Reflow-Soldering/AltiumDesigner/수정된 사양서/(번역본)Mixed Signal Board 요구사항.docx

Mixed Signal PCB Design

요구사항

개발 작업 설명

중앙 컨트롤 보드

제작사항:

  - 회로도
  - 회로도에 따른 PCB 레이아웃(PCB 설계)

해당 보드의 경우, 사용자가 가지고 있는 설계 프로그램에 따라 다를 수 있으나, 실제적으로 도식의 이해가 가능하면 허락함.
단, 해당 작성자는 Altium만 사용하도록 한다. Altium의 적응을 높이기 위함

부품 및 통신 방식

  - MCU:
    - STM32F103디버거가 포함된 STM32F407시리즈
  - 통신 사양:
    - Ethernet (통신 속도 : 2MB/s)
    - USB 2.0
    - CAN Bus (통신 속도 : 1MB/s)
    - UART
  - 기타 부품
    - ADS1220C04PW
      - Programmable Gain Amplifier
      - Resolution : 24bit
      - Sample Rate 100SPS
      - 0~10mV 차동 입력 진행(Common Mode 전압은 2.5V)
    - DRV8701
      - Bi-Directional Motor Driver 2개
      - Duty: 0% to 100%
      - Power Consumption: 12V 3A (36W)
    - I2S를 이용한 DAC 헤드폰, 스피커 앰프
    - 마이크와 연결될 CODEC

개발자에 따른 사양 지정 – 여기서는 교육 내용과 똑같이 진행한다.

  - Ethernet Physical IC
  - Vref IC, Regulator, Clock Generator
  - 그 외 부품(교육 내용을 따라가도록 한다)
  - 전원 스위치
  - 커넥터

위와 같은 사양으로 진행하며, 부품을 개인차에 따라 쓰지 않는 이유는 이미 라이브러리 제공이 되어있으므로 이를 이용하기 위한 목적이다.

HIGH-SPEED BOARD DESIGN TASK - AUGUST 2017 2
