Reflow-Soldering/AltiumDesigner/다운로드 리소스/Component Naming Convention.xlsx

Sheet: Schematic
SL.No | Part Type | REF-DES | Comment | SYMBOL REFERENCE | Examples
1 | IC'S | U | Part name | IC_Part No.
2 | CRYSTALS | Y | Value | XTAL_Frequency-p art no.
 | Oscillator | Y | Value | OSC_Frequency-Pa rt No.
 | Resonators | X | Value | XTAL-R_Frequency -Part No.
3 | CAPACITORS
 | Capacitor | C | Value | CAP_value-voltage- tolerance-Package
 | Capacitor Polarised | C | Value | CAP-P_value-voltag e-tolerance-Packag e(Case CODE) | CAP-P_10F-50V-10 %-1411(CASE-B)/R AD | RAD- Radial
 | Capacitor Non-Polarised | C | Value | CAP_value-voltage- tolerance-Package
 | Capacitor networks | CN | Value | CAP-N+No. of pins_value-voltage-t olerance-Package
 | Capacitor arrays | CA | Value | CAP-A+No. of contacts/row_value- voltage-tolerance-P ackage
 | Capacitor Variable | C | Value | CAP_value-voltage- tolerance-Package
 | Capacitor Box | C | Value | CAP-B_value-voltag e-tolerance
 | Capacitor Kit | CK | Value | CAP-K_value-voltag e-tolerance-Packag e
4 | DIODES
 | Diode | D | Part name | DIO_Vr -Current If-Package
 | Diode Array | D | Part name | DIO-A_Type-PartNo -Package | DIO-A_S/T/Z-Part No.-Package
 | Diode Zener | D | Part name | DIO-Z_Voltage Zener (Vz)-Power-Packag e
 | Diode schottky | D | Part name | DIO-S_Voltage forward Vf-Voltage reverse Vr-Current forward If-Package
 | Diode TVS | D | Part name | DIO-T_Voltage breakdown Vbr-Voltage Vc-Current Ip-Package
5 | FUSES
 | Fuse | F | Value | FUSE_Trip/Rating c urrent-voltage-pack age-Type | FUSE_0.20A-30V-1 206-RST (RST- Resetable, NON-RST-- Non Resetable )
 | Fuse thermal | F | Value | FUSE-T_Trip current-voltage-pac kage-Type
 | Fuse Holder | FH |  | FUSE-H_Part No-Package/Mounti ng type | FUSE-H_3557-2-T H
 | Fuse Assembly | FA |  | FUSE-A_Trip Current/Current Rating-Voltage-Pac kage/Mounting Type-Type
6 | FILTERS
 | Filter | FL | Part name | Filter_Type-Attenua tion Value-Voltage rated-Current-Pack age/mounting type | FILTER_LP-44dB@ 100MHz-500V-10A- 2220
7 | FERRITE BEAD
 | Bead Ferrite | B or FB | Value | FB_Impedance-freq uency-current rating-package
 | Bead Arrays | B or FB | Value | FB-A+no. of contacts/row_Imped ance-frequency-curr ent rating-package
8 | JUMPER | JP | Value | JMP+no. of channel_package/Pi tch/Part No
 | Jumper CAP |  |  | JMP+no. of channel_Package/P itch-CAP
9 | INDUCTORS
 | Inductors | L | Value | IND_value-current-t olerance-Package/ Mounting type
 | Inductor-Iron | L | Value | IND_value-current-t olerance-Package/ Mounting type
 | Inductor variable | L | Value | IND-V_value-curren t-tolerance-Package /Mounting type
 | Choke | L | Value | IND-C_impedance @frequency-Curren t-Mouting type | IND-C_220Ohm@1 0kHz-6A-TH
 | Inductor Kit | LK | Part name | IND-K_Value Range-Part No-Package/Mounti ng type | IND-K_0.10~33uH- SRP-A-LAB2-S MT
10 | LED'S & DISPLAYS
 | Single LED | DS | Part name | LED_color- Voltage Vf- Current If-Package | LED_YLW/RED/BL U/GRN-2.2V-20mA- package
 | DISPLAYS | DS | Part name | DSP_Configuration- color-Part No-Package | DSP_128x64LCD-Y LW-JHD12864E-TH
 | LED RGB | DS | Part name | LED_RGB-Part No.
 | LED Others | DS | Part name | LED-Type_Part No-Package/Mounti ng type | LED-IR_VSMY3850 -GS08-SMT
11 | MOV | MOV | Part name | MOV_AC voltage-clamp voltage-Package/M ounting type
12 | POTENTIOMETER S | POT | Value | POT_value-Part No_Package/Mounti ng type
13 | RELAYS
 | Relays | RL | Part name | RLY+no. Of channels_Coil voltage-coil current | RLY2_4.5V-2A
14 | RESISTORS
 | Resistor | R | Value | RES_value-wattage -tolerance-package | RES_0.005R-1W-1 %-1632
 | Resistor networks | RN | Value | RES-N+no. of contacts_value-watt age-tolerance-pack age
 | Resistor arrays | RA | Value | RES-A+no. of channels_value-wat tage-tolerance-pack age | RES-A4_0.005R-1 W-1%-1632
 | Resistor Variable | VR | Value | RES-V_value-watta ge-tolerance-packa ge
 | Resistor tapped | R | Value | RES-T_value-watta ge-tolerance-packa ge
 | Resistor Kit | RK | Value | RES-K_value-watta ge-tolerance-packa ge | RES-K_10~97.6R-6 2.5mW-1%-0402
15 | REGULATORS | U | Part name | REG_Voltage Vi-Voltage Vo- current-wattage-Pac kage/Mounting type
16 | RECTIFIERS | REC | Part name | REC_Type-PIV- Voltage Vf@Current If-Package/Mountin g type
17 | SWITCHES
 | SWITCHES | SW | Part name | SW+No of Channels_Part No-TH/SMT
18 | SPEAKERS | SPK | Value | SPK_wattage-impe dance
19 | TRANSISTORS
 | NPN | Q | Part name | TRNS-NPN_ Voltage Vce- Current Ice-package
 | PNP | Q | Part name | TRNS-PNP_ Voltage Vce- Current Ice-package
 | IGBT | Q | Part name | TRNS_Voltage Vceo- Current Ic-package
 | MOSFET | Q | Part name | MOSFET-N or P_Voltage Vds- Current Id-package | N : N channel ; P : P channel
 | Array | Q | Part Name | TRNS-A_ PNP/NPN/(PNP-NP N)-Voltage Vce- Current Ice-package | TRNS-A_PNP-45V- .1A-SOT-353
20 | THERMISTORS | RT | Part name | RT_Resistance-Typ e-package
 | THERMISTOR ASSEMBLY |  | Part name | RT-ASMLY_Thermi stor Part No_Housing part No_Crimp Type | RT-ASMLY_NTCLE 100E3222HB0_440 129-2_SKT
21 | TEST POINT | TP |  | TP_Size-SMT/TH | TP_30D60_TH, TP_40x40-SMT
22 | TRANSFORMERS | T | Part name | XMER_No of contacts-Part No.
23 | CONVERTERS | U | Part name | MOD-AC/DC_Part No.
24 | MODULES | U | Part Name | MOD-Type_Part No. | Eg2: MOD-RF_XB8-DM US-002
25 | SENSOR MODULES | U | Part Name | SNSR_Type-Part No-Mounting Type
26 | ANTENNA | ANT | Part name | ANT_Frequency-Pa rt No
27 | GDT | GDT | Part Name | GDT_Impulse Discharge Current_Voltage
28 | Mechanical Part | MP | Part name | MP_Part No_SMT/TH
29 | Board
 | PCB |  |  | PCB_XXX-XXX-RX XX
 | Gerber |  |  | GBR_XXX-XXX-RX XX
 | Evaluation board |  |  | EVAL_Part No
 | Library |  |  | LIB_XXX-XXX-RXX X
30 | VARISTORS | RV | Part Name | VAR_Varistor Voltage (Typ)-Current -Mounting Type/Package
31 | Light Pipes | LP | Part Name | LP_No of Diffusers-Part No.-Related Package
32 | FAN/LAMP | FA | Part Name | FA_FF-Dimensions( LxB)-Cutout Size-Mounting(Pan el Cutout/Click fitting)-Color
33 | TEST PROBE |  | Part Name | TEST-PROBE_PA RT NO.
 | lithium polymer |  | Part Name | BAT-LP_Capacity-P art No-Type-Shape |  | Non Rechargeble: NON:RCH Rechargeble: RCH
35 | BATTERY HOLDER | BH | Part Name | BAT-H_Part No-Typ e of Battery-Mountin g Type
36 | TBU | TBU | Part name | TBU_Working Volt-Clamping Volt-ESD (Volt)-Mo unting Type | TBU_300V-650V-2 KV-SMT

Sheet: Connectors
SLNO | PART TYPE | REF-DES | VALUE FIELD | DESCRIPTION | Examples
1 | GENERAL TYPE
 | Berg strip | P/J | Part name | CON-BS-PLG/SKT_Pin s in the row X no.of rows-Pitch-mating type-mounting type | CON-BS-SKT_5X2-100 -ST-TH
 | PLUG - Plug | P | Part name | CON-PLG_Pins in the row X no.of rows--Pitch-mating type-mounting type | CON-PLG_80X2-100-R A/ST-TH/SMT
 | SOCKET- Socket | J | Part name | CON-SKT_Pins in the row X no.of rows-Pitch-mating type-mounting type | CON-SKT_80X2-100-R A/ST-TH/SMT
 | TRBLK-Terminal block | J | Part name | CON-TB_Pins in the row X no.of rows-Pitch-mating type-mounting type
 | EDGE-Edge connectors | J | Part name | CON-ED_No.of Pins-mounting type
 | FLEX-Flex connectors | J/P | Part name | CON-FLX_Pins in the row X no.of rows-Pitch-mating type-mounting type
 | BNC | BNC | Part name | CON-BNC_No.of Pins-Pitch-mounting type
 | IDC Connector | J | Part name | CON-IDC+No of Pins_Pitch-mounting type
 | Housing | J/P | Part name | CON-HSG+Pins in the row X no.of rows_Pitch-mating type | CON-HSG2X2_100-ST/ RA
 | BOX- box type | J/P | Part name | CON-BOX+No of Pins_Pitch-mounting type
 | Circular Connector | CN | Part name | CN_PM_C-Shell Type-No. of Pins-Plug/Socket-A/B/X /S"Space"Coded | CN_PM_C-M12-12POS .-SOCKET-A CODED
2 | EURO CONNECTORS
 | P - Plug (Male) | P |  | CON-EP_Pins in the row X no.of rows-mating type-mounting type
 | R - Receptacle(Female) | P | Part name | CON-ER_Pins in the row X no.of rows-mating type-mounting type
3 | Special DIN CONNECTORS
 | CIRDIN - Circular din connector | DN | Part name | CON-CIRDIN_No.of Pins-mounting type
 | MDIN - Miniature din connector | DN | Part name | CON-MDIN_No.of Pins-mounting type
4 | DSUB connectors
 | STD DSUB Connector | P | Part name | CON-DSUB_No.of Pins-mating type-mounting type
 | STD DSUB Connector Housing |  |  | CON-DSUB-H_No.of Pins-mating type-mounting type
 | BACKSHELL |  |  | CON-SHELL_No.of Pins-Length(mm)-matin g type
5 | MEMORY MODULES
 | SIMM | J | Part name | MM-SI_No.of Pins-mounting type
 | DIMM | J | Part name | MM-DI_No.of Pins-mounting type
 | SD Card | J | Part name | SD-Family_Type-Stora ge | SD-HC_Mico-8GB
6 | Special Connectors (Irregular pitch/circular) | J | Part name | CON+no. of pins_Connector type-Part No. | CON4_USB-A-87520-0 010BLF
 | RJ PCB Mount | J | Part name | CON-RJXX_Part No-M ating type-mounting type | CON-RJ45_SS71800-0 27F-ST-TH
 | Hermaphroditic Connector | JP | Part name | CON-HC_Pins in the row X no.of rows_Pitch-Part Number_mounting type | CON-HC_50X2_25_LS S-150-02-F-DV-A_SMT
7 | Coaxial Connectors | J/P
 | PLUG - Plug | P | Part name | CON-Connector Style-S KT_Part No-Mounting type | CON-SMA-SKT_5-1814 832-1-TH
 | SOCKET- Socket | J | Part name | CON-Connector Style-P LG_Part No-Mounting type
8 | CRIMP
9 | HDMI, DVI Connectors | J/P
 | HDMI Connectors | J/P | Part name | CON_Connector type_Part No-Mating type-Mounting type | CON_HDMI-A/B/C/D/E _685119136923-RA-TH
 | DVI Connectors | J/P | Part name | CON_Connector type_Part No-Mating type-Mounting type | CON_DVI-A/D-S/D-D/I- S/I-D_0743201007-RA- TH

Sheet: Footprint
FOOTPRINT NOMENCLATURE
1 | IC | PACKAGENAME+NO OF PINS_PITCH_OUTER TO OUTER DIAMENSION_PADWIDTHX PADLENGTH_MOUNTING | SOIC8_50_284_25X90_SMT
2 | Modules | MOD_ManufacturePartNo_M ountingType
3 | Capacitor | CAP_Package
4 | Tantalum | TCAP_Package_Case Code | TCAP_1210_CASE-T
5 | Aluminium | ACAP_Pitch_Body Dimension_Mounting type | ACAP_P3.5_5X3_H8_SMT | in mm
6 | Electrolytic | ECAP_Pitch_Body Dimension_Mounting type | ECAP_P3.5_D5_H8_TH | in mm
7 | Other Cap | CAP_Pitch_Dimensions_Mo uting type
8 | Resistor | RES_Package
9 | Resistor Array | RES+No of Channels_Package/Part No_Mounting type.
10 | Potentiometer | POT_Part No_Mounting type.
11 | Crystal | XTAL_Part No | For Vertical component add -VM at the end of convention
12 | Oscillator | OSC_Part No.
13 | Diode | DIO_Package_Mounting type. | DIO_DO-35_VM
14 | Std Connector | CON+No of pins_Pitch_DrillDPAD_moun ting type_mating type | CON3_78-74_32D66_TH_R A
15 | Other conn | CON+No of pins_Pitch_Part No_Mating Type_mounting type | CON80_31.49_FX18-80P-0. 8SV10_ST_TH
16 | RJXX Conn | CON+No of pins_RJXX_Part No_Mating Type_mounting type
17 | Dsub Conn | CON_DB+Pin No. _PLG/SKT_Mounting Type | CON_DB25_PLG_TH
18 | Transformer | XMER _Part Number_TH/SMT | XMER_HX1188FNLT_SMT
19 | Switch | SW_Part No_TH/SMT
20 | Inductor | IND_Package/Part No_TH/SMT
21 | LED | LED_Package/Part No_TH/SMT
22 | FUSE | FUSE_Package/Part No_TH/SMT | FUSE_37414000410_TH-RA D
23 | GDT | GDT_Part No_TH/SMT
24 | RELAY | RLY_Part No_TH/SMT
25 | MOV | MOV_Part No_TH/SMT

Sheet: Footprint Creation
Footprint Creation and Nomenclature
 |  | Outer to Outer = distance between pad outer edges (WL)
 |  | Inner to Inner = distance between pad inner edges (Wb)
 |  | Pitch = distance between two adjacent pads/pins center (P)
 |  | Pitch 1 = distance between two pads/pins center of other row
 |  | Pitch 1 = Outer to Outer- 1 pad length
 |  | Inner to Inner = Outer to Outer- 2 pad length
 |  | Preferred pad length for soldering 0.5mm(20mils
Footprint creation from component diag (std)
QFN & DFN | Outer to Outer = Outer to outer(data)+50 | Pad length = pad length (data)+25
SOP,LCC & OTHER QUAD PACKAGES | Outer to Outer = Outer to outer(data)+40 | Pad length = pad length (data)+40
BGA | Pad dia = dia(data)x.8+1
Discrete | Give minimum 20 mils for soldering
COMPONENT OUTLINE (comm on) | Body Length = L(data)+20 mils
Fiducials for component= 20D40 |  | 20 mils pad,40mils soldermak & 40mils layer keep out
Fiducials for board(global)= 40D80 |  | 40 mils pad,80mils soldermak & 80mils layer keep out
