Reflow-Soldering/AltiumDesigner/수정된 사양서/프로젝트 사양서.xlsx

Sheet: DAY-1(한글)
개발 사양서 조건표
요구 사항 | 확인사항 | 실제 사양 | 가능여부 | 비고
MCU (STM32F407Vx,Zx,Ix 3종 중 하나) | GPIO 수 | 가변(Package 및 MCU 따라 변경) | 무관
 | I2C 수 | 가변(Package 및 MCU 따라 변경) | 최소 1개 가능
 | UART 수 | 가변(Package 및 MCU 따라 변경) | 최소 1개 가능
 | Clock | 최대 168MHz | -
 | Flash 용량 | 512KB/1024KB | 코드 용량에 따라 다름
 | RAM | System : 192KB Backup : 4KB | 처리에 따라 다름
 | VDD | 최대 4V(VDD) | 기본 3.3V 진행
Debug Environment (STM32F103) | 동일 벤더 디버거 | ST-LINK 계열 | 부품 추가
 | 동일 사양 버스 필요 | - | 32bit Bus Line
비트 주소 | Bit 수 | 32Bit | 2^32
 | Clock 주파수 | 미정 | 168MHz 이하여야함
 | Prog. Interface | SWD방식
Ethernet PHY | Datalink Layer | LAN, WAN, Wireless | 광통신,Twisted Pair | MAC Address 사용
 | Physical Layer | H/W(Raw Data)
MII/RMII | Media | 사양서는 2MB/s bit로 환산 시 16Mb/s MII에 만족함 | MII로 선정 가능 | https://blog.naver.com/mhyoo1228/221856706981
MII(신호선 16개) | 100Mbits/s
RMII(신호선 7개) | 1Gbits/s
GMII(신호선 24개) | 10Gbits/s
MII Clock | 25MHz
RMII Clock | 50MHz
Phy | 드라이버 사용가능
UART to USB Converter | FT232, CH340C |  | 부품 추가
CAN Bus | - | MCU 가능 | 가능
UART | - | MCU 가능 | 가능
Analog To Digital Converter | 비트 수 | 24 | MCU 12 bit 부품 추가
 | Reference Regulator | 5V
 | Program Gain Amp | 128
 | Sampling Rate | 100SPS
 | Data +, Data - | 0 ~ 10mV
4-Wire Load Cell | CM Voltage | 5V | 부품 추가
Sensor(5KG Load Cell) | 5Kg Load Cell 감도 | 1mg/V | 총 5mg 측정가능
 | 인가전압 | 5V
 | 스텝 수 | 1000000
 | 필요 ADC 비트 | 20bit이상
ADC | 샘플링 비 | 100SPS | MCU 12bit 불가 differential 부품 추가
 | 샘플링 필터 | -
 | 채널수 | 1개
 | 통신 | UART, I2C, SPI
 | 추가기능 | ESD, Noise rejection
 | Noise Free Bits | -
 | Effective Bits | -
 | Voltage Level | -
Motor Driver | Bi-Directional | Bi-Directional Modor(H type) | 부품 추가
 | 0-100% | PWM
 | Motor Input Voltage | 12V
 | Logic Level H Voltage | 3.3V
 | Motor Type | Brushed DC
 | TR종류 | Power MOSFET
 | 규격 | GPIO 1, PWM 1
 | 보호 기능 | OVC
 | 전류측정 | 1 ADC
 | 가격 | -
MOSFET | Rds(on) | 작을수록 좋음 | 부품 추가
 | Id | 3.5A 초과
 | V(gs) | 9V 초과
 | Ids(Off) | 최소
 | Power Disspiation(Pd) | I^2*Rds(on)
 | Rth(JA) | 최소 온도(발열로 인한 손상 최소화)
 | Total gate charge | 최소 Q로(Gate Open Delay 최소화)
 | Switching Loads(inc) with total gate Charge
 | no elements
DAC | Sampling Rate | 64x Fs
 | 요구 채널 수 | 1채널
 | 통신방식 | I2S
 | 분해능 | 32bit
 | 아날로그 출력 수 | 1개 -> 헤드폰, 스피커
 | 전압 | 3.3Volt
 | 마이크 | 1개 -> 헤드폰
 | monotocity | -
 | 오디오 범위(dB) | High minus low Audio
선정 부품 | 모델명 | 제조사 | 패키지 | Description
MCU | STM32F407VGT6 | STMicroelectronics | LQFP100 | Cortex-M4, FLASH 1MB, 12bit ADC, SRAM 192KB
Progammer/Debugger | STM32F103CBT6 | STMicroelectronics | LQFP48 | Cortex-M3, FLASH 128KB, 12bit ADC, SRAM 20KB
Ethernet PHY | DP83826IRHBR | Texas Instruments | QFN-32 | PHY MII,RMII
UART to USB 2.0 | CH340C | WCH(China) | SOP-16 | USB to Serial
ADC (Load Cell용) | ADS122C04IPW | Texas Instruments | TSSOP | 24bit ADC, PGA, Reference, 4-ch(Single), 2-ch(Diff)
Motor Driver | DRV8701ERGET | Texas Instruments | VQFN-24 | PH/EN Control, H-bridge Motor control
MOSFET | DMHT6016LFJ | Diodes | V-DFN5045-12 | 60V N-CHANNEL ENHANCEMENT MODE MOSFET H-BRIDGE
DAC | CS43L22 | CIRRUS LOGIC | QFN-40L | Low Power, Stereo DAC(headphone, Speaker amps)
마이크 | IMP34DT05 | STMicroelectronics | HCLGA 4LD | MEMS audio sensor omnidirectional digital microphone
RLC | - | Any | Any | R,L,C 종류별 사용
특수 부품 | Ferrite Bead, OSC 등 | Any | Any | 종류별로 사용

Sheet: DAY-2(한글)
STM32F103 Debugger 참조 사항
참조 | Page | Description | 내용 | 비고
STM32F103 Datasheet | Page 11 | 블록 다이어그램 | 전체적인 내부 구조 설명 | JTAG/SWD 블록 확인
 | Page 15 | Boot Modes - 3 State | Boot 모드 설명 | AN2606 - Chapter 18 참조(부트모드) - 19는 105 Reference Manual도 참고할것
 | Page 26 | LQFP 48 PinOut | Pin Out 설명 | 각 핀의 명칭 포함되어있음
 | Page 28-33 | 103 Pin Definition | Pin Description | 각 핀 Deafault/Altenative 포함
 | Page 35 | Load Cap, VDD | Load Cap(for OSC), VDD 구조 | 기본 3.3V 테스트/ 테스트 방법
 | Page 36 | Power 구조 | (A)VDD,(A)VSS,Vref 설명 | Voltage만 나오지만 블록 다이어그램 있음
 | Page 37 | Absolute maximum ratings | 절대기준(V,I 등) | 절대 기준, Operating Condition으로 볼 것
 | Page 51-56 | Clock Config | 내부 클럭/외부 클럭 설명 | External 8MHz 사용 할 예정
 | Page 59 | ESD(정전기) | 저항 가능한 정전기 | 인체/충전기모듈 기준 설명
 | Page 66 | NRST Pin | RESET(Active Low) | 테스트 리셋 불필요 시 스위치 불필요
 | Page 69 | I2C 사용 주의 사항 | Should place Pull-up | 풀업 저항 + 직렬 저항(노이즈 떄문인듯)
 | Page 77 | Design Guidelines | General PCB Design | 가이드라인 제시
Bypass Caps
Series Termination Resistance | 1Mhz | 3.3v<x
 | ns
10R | 0.2V

Sheet: Day-3(한글)
ESD Diode/Ferrite Bead 선정
내용 | 속성 | 요구사항 |  | 비고 | 선택 부품
ESD DIODES/TVS DIODES | 누설전류 | 적을수록 좋음 |  | 전력 소모량에 영향 | ESD3V3D9 |  |  | Clamping 전압은 MCU의 Absoulte maximum voltage 보다 낮은게 좋긴 하다
 | 동작전압 | 3.3V |  | MCU 공급 전압에 따름
 | Break down 전압 | 3.3V보다 클 때 |  | 3.3V보다 클 때와 반응속도가 빨라야함
 | 클램핑 전압 | 동작전압에 가까울 수록 좋음 |  | MCU공급 전압이 3.3V이므로
 | 기생 커패시턴스 | 최소 |  | 고주파에서 GND로 가며, 신호 감쇠 영향
 | 방향성 | 단방향 |  | 0~3.3V이므로
Magnetics with RJ45 | RJ45 Magnetic | 절연상태(내부 Trans 사용) |  |  | G8X-188S7-BP
 | Working Voltage | -
 | Isolation Voltage | -
 | Speed | 100Mbps 가능 |  | 요구사항 2MByte/s
Ferrite Bead | Rdc | 낮을수록 좋음 |  | 높으면 전압 강하를 일으킴 | MPZ1608B471ATA00 |  |  | 비드는 노이즈를 확인하고 특정 주파수 라인 제거를 목적 (Knee Freq 확인 필)
 | IMP | 높을수록 좋음 |  | 원하는 주파수 내에서만 높아야함
 | FREQ | 요구 주파수 내 |  | 원하는 주파수에서의 임피던스 확인 필
 | Current | Ethernet PHY TX+, TX-, RX+, RX- 라인당 전류 |  | 동작 전류보다 낮으면 발열/소손 예상
SWD/JTAG | JTAG과 SWD는 선택사항 |  |  | SWD -> 프로그램, 디버깅, ARM 아키텍쳐, printf 가능 JTAG -> Test, 독립적, 별도의 아키텍쳐 없음
Symbol Desing | IPC-STD-2612
Footprint | IPC-STD-7351
 |  |  |  |  |  | 용량성 리액턴스(Xc) | 1/(2*pi*C) | FC(High), C(High) Imp (Low)
 |  |  |  |  |  |  | TX+, TX-, RX+, RX-
 |  |  |  |  |  | SWD | SWDIO, SWCLK, GND
 |  |  |  |  |  | JTAG(4/5) | JTNRST, JTCK, JTMS, JTDI, JTDO, GND
 |  | SWD | JTAG
 |  | Programming / debugging | testing (Max processing)
 |  | Arm arch | independent
 |  | print during deb | not

Sheet: DAY-4(한글)
모터 드라이버 IC 설계 사항
명칭 |  | 단위 | 결과 | 설명
ICHOP |  | 3A | 3A | 지정된 전류값 초과시 정지한다 Vref 필수 - AVDD에서 분압
VREF |  | Unknown | 3.05V | Chopping 위한 Vref 레벨 8.2.1.2.3 참고하여 계산
VOFF |  | 0.05V | 50mV | VOFF시 Typical 전압
AVDD |  | 4.8V | 4.8V | 내부 레귤레이터 6.3V 1uF 세라믹 권장
Gain(Av) |  | 20 | 20V/V | ICHOP위한 내부 증폭값(Rsense)
Vout(Vref 값) |  | r2*vin/(r1+r2)
r1/r2 |  | 1.8/3.3 | 0.5
r1 |  | 1.5k
r2 |  | 3k
Page no |  | 17
application Page |  | 28
BULK CAPS 선정 | MEANWELL RS-100-12 기준
최소 커패시터 용량 | D*(1-D)*IO/ DELV*Fsw
최대 스위치(Delta) | Vo*100/VIN*eff | 1-((Vin-효율)/Vout)
I0/요구 전류 | 7.6A
VIN=VOUT | 12V
스위칭 주파수(fsw)/민웰 | 60000
효율(eff)/민웰 | 81
출력 리플(delv)/민웰 | 0.12(peak to peak)
최종 리플(Delta) | 1.234568
Cmin | 250uF
3A | ~100uF
ESR | min
Ripple Current | Max
ADC
Page No |  | 52 | Filter Calc |  | 전류(고정) | Voff(고정) | Av(고정) | Rsense | SO(Volt)
FC |  | 1/(2*PI*(R1+R2)*CDIF) | r1=r2=1k |  | 3 | 0.05 | 20 | 0.05 | 3.05
1000
CDIF |  | 100nF
CM1=CM2 |  | 10nF

Sheet: DAY-5(한글)
Charge Pump: | i/p 12v | 24v | Caps | Polar | Non polar
 | 12 |  |  |  | Ceramic
Arangement of Capacitor, Diode, CLK, Gates |  |  |  |  | Class a, Classb
V1 + V1 | 2X 5V | Load voltage |  |  | Class a (Stable, Low Leackage, Low ESR)
Adv | Less compo | Min complex |  |  | MLCC(multilayer ceramic capacitor)
STM32F407
Page-19 | block | SWD/JTAG
Page-24 | Boot pins
Page-25 | PRD ON and Vdd conditions
Page-77 | VDDs, VREF, AVDD, GNDs |  | Pending
Page-82 | Low esr req. for Vcap1 &2 |  | PHY RESET | GPIO
Page-102 | Crystal req |  | Motor driver | 1 PWM, 3 GPIO, 1ADC _IN | X2
Page-112 | ESD Ratings |  | CH340C | 1GPIO
Page-119 | Reset conditions |  | ADC | 2 GPIO
 |  |  | DAC | 1GPIO
 |  |  | MIC | 1 PWM 1 GPIO
Place zener on 1.8
Change net labes motor-2

Sheet: DAY-6
Rules | Some Advantages of MultiLayer Board
First thing is these rules are not enough, because there can be 100s of Rules for a complex PCB. | increases the board's ability to distribute energy
1. ground plane boards are better because they allow signal routing in a microstrip or stripline configuration. It also significantly reduces the ground impedance and, therefore, the ground noise; | reduces cross-interference, eliminates electromagnetic interference
2-high speed signals should be "routed" on intermediate layers located between the various levels. In this way, ground planes can act as a shield and contain the radiation coming from the tracks at high speed | supports high-speed signals
3- a signal layer must always be adjacent to a plane | While a stackup level allows you to get multiple electronic circuits on a single board through the various layers of PCB board
4- Multiple ground planes are very advantageous, since they lower the board's ground impedance and reduce radiation in a common way; | a stack of PCB layers can help minimize the circuit vulnerability to external noise, as well as minimize radiation and decrease impedance and crosstalk problems on high-speed systems
5. the power to Power or GND to GND planes must be rigorously coupled together; | good PCB stacking can also contribute to efficient and low-cost final production;
6- Configurations should be symmetric. For example, on an eight-layer PCB, if level 2 is a plane, level 7 should also be a plane | a correct stack of PCB layers can improve the electromagnetic compatibility of the project.
7. Put the signal levels next to the levels of the plane (ground or power) the return current can flow on an adjacent plane reducing the inductance of the return path to a minimum; | The higher the number of layers, the more the designer is free to unravel his circuit, with less chance of stumbling into "impossible" solution
8. to further improve noise and EMI performance, insulation between a signal layer and its adjacent plane can be made even thinner;
9. an important consideration to be done is the thickness of each signal layer. There are standard thicknesses together with the properties of different types of printed circuit material. When selecting the materials, it is advisable to consider their electrical, mechanical and thermal properties;
Following Factors we have to thing Before and during the design
No of Layer
Number of Planes and Type of Planes
Sequence of Layers
Spacing b/w the Layers

Sheet: Grounding
Grounding
1- Leave nothing unconnected (Fill gnd)
2- Never split the gnd under the signal (Multilayer )
Always connect gnd on common point
Minimize the series via (High freq)
Try to route GND tracks from the biginning (2 layer , 1 layer)
GND to Chasis GND
Reason of Chasis should be gnd(To electric shock)
Current flow from body
higher potential (Body is lower pot)
Lets suppose something touching chasis
0V at chasis
to maintain 0v on chasis we connect it to GND
Very Big PCB, (Try to place Low value cap and Mega ohm reg on every monting hole)

Sheet: day-10
Reverify the schematic | Power Nets | Loads
Critical (Reset, Analogs, sesnors, etc) -Create design rules for Clearance | 12v | 12v (Q2), 12V(U9) | R19
Differential Tracks | 12v Series element NETC84_2 | 3V3 (u8),
Digital tracks | 3V3 | 1v8(u6), 3v3(u6,u7),
Check for each polygon pour | 12v Series element NETC90_2 | 3v3(u5)
 | 1v8 | 3v3(u4)
Place all the designators and naming | 3v3 Series load Net c11_2 | 12v(q1), 12v(u3) | R43
Add a clearance rule for 5mil, adjust all the violations |  | 3v3(u2)
 |  | 3v3(u1)
Current density, Voltage drop (PDN Analysis)
A/unit area

Sheet: Bonus Session
All I/O Voltage Nets | Loads at different Volatge
12V | 12V (Q1,Q2), Current Sesnse (R19, R43)
Series Ele. Netc84_2 | NETC84_2 (U10)
3V3 | 3V3(U1, U2)
