Reflow-Soldering/AltiumDesigner/다운로드 리소스/ADCs Criterias .xlsx

4 Channel ADCs |  |  |  |  |  |  |  | 2020-07-01
MPN | I2C Com | Resolution | Sample rate | PGA(gain amp) | Digital Filter Samples | I/P Volatge | Sensing Voltage | Price < $2 | Distributor
Not Available on arrow & lcsc price started from $2.1
AD7993BRUZ-1 | y | y | 188k |  |  | 3.3v to 5.5v |  | 2.1 | ARROW
ADS7924IRTER | y | 12 | 100K |  |  | 3.3v to 5.5v |  | 2.72
AD7091R-5BCPZ-RL7 | y | 12 | 22.2k |  |  | 3.3v to 5.5v |  | 2.6
ADS7924IRTET | Y | 12 | 100K |  |  | 3.3v to 5.5v |  | 2.1 | LCSC
TLA2024 (https://www.ti.com/lit/ds/symlink/tla2024.pdf?ts=1596114651694) |  |  |  |  |  | 3.3v to 5.5v |  | 1.3 | Digikey (https://www.mouser.in/ProductDetail/Texas-Instruments/TLA2024IRUGR?qs=chTDxNqvsymxVYMOXLVZ5Q%3D%3D)
ADS1015 (https://www.mouser.in/ProductDetail/Texas-Instruments/ADS1015IDGSR?qs=IK5e5L0zOXhCrFZ0pftZqw%3D%3D) |  |  |  |  |  | 3.3v to 5.5v |  | 2.66 | Mouser (https://www.mouser.in/ProductDetail/Texas-Instruments/ADS1015IDGSR?qs=IK5e5L0zOXhCrFZ0pftZqw%3D%3D)
1 Channel ADCs |  |  |  |  |  |  |  | 2020-07-01
MPN | I2C Com | Resolution | Sample rate |  |  |  | Sensing Voltage0-3.3V. | Price < $2 | Distributor
ADC081C021CIMM/NOPB | Y | 8 | 188.9K |  |  | 3.3v to 5.5v | Y | 1.49 | ARROW
MCP3021A7T-E/OT | Y | 10 | 22.3K |  |  | 3.3v to 5.5v | Y | 0.9 |  | i2c Adress Options
MCP3021A3T-E/OT | Y | 10 | 22.3K |  |  | 3.3v to 5.5v | Y | 0.7
MCP3021A2T-E/OT | Y | 10 | 22.3K |  |  | 3.3v to 5.5v | Y | 0.77
MCP3021A4T-E/OT | Y | 10 | 22.3K |  |  | 3.3v to 5.5v | Y | 0.9
MCP3221A4T-E/OT (https://www.mouser.in/ProductDetail/Microchip-Technology/MCP3221A4T-E-OT?qs=uHi2%2FQoPa5A0hdg9CKvRxA%3D%3D) | Y | 12 | 22.3K |  |  | 3.3v to 5.5v | Y | 1.14 | Mouser
Aanalog MUX
8:1 Mux
MPN | Volatge Range | Price
74HC4051PW,118 | 2-5.5V | 0.3
74HC4051PW-Q100,11 | 2-10V | 0.23
74HC4051PW,112 | 2-10V | 0.2
74VHC4051AFT | 2-5.5V | 0.34
TMUX1208 |  | 0.6
8:2 MUX
MPN | Volatge Range 2-6 | Price
MC74VHC4052DR2G | Y | 0.3
SN74HC4852DR | Y | 0.28
NLVHC4052ADWR2G | Y | 0.26
M74HC4852YRM13TR | Y | 0.27
