Reflow-Soldering/AltiumDesigner/다운로드 리소스/MOSFET PARAMETERS.xlsx

Sheet: Index of Mosfets(n channel)
PARAMETERS | RDS(ON) | VDS(V) | ID @100 Deg C | VGS-TH | Transconductance | VGS-MAX | IDSS | P(DIS)-W (ILOAD^2 X RDS) | RTJA | Temperature Rise at ILOAD | Comments |  | Vendors | Total gate charge | I/P Capacitance | SW Freq | Thermal Pad | Bridge confrigration
MOSFET
HAT2092R | 10V, 5.5A, 16mOHM | 30V | 11A |  |  | 20V | 1UA | 0.484 AT 5.5A |  |  |  |  | ARROW | 22NC | 1400PF |  | NO | 2 ELEMENT
IRFHM8363T | 10V, 10A- 14.9mOHM | 30V | 10A |  |  | 20V | 1UA | 1.5W AT 10A | 47 |  |  |  | ARROW | 15nC | 1165PF |  | NO | 2 ELEMENT
IRLHS6242TRPBF | 4.5, 8.5A- 11.7mOHM | 20V | 8.5A |  |  | 12V | 1UA | 0.8W AT 8.5A | 63 |  |  |  | LCSC | 14NC | 1110PF |  | YES | NO
BSZ0909ND | 4.5V, 9A- 25mOHM | 30V | 20A |  |  | 20V | 1UA | 2W AT 9A | 65 |  | Upto 6 Amps Max |  | ARROW | 2.6NC | 360PF |  | YES | 2 ELEMENT
DMHT6016LFJ | 10V , 10.6A, 22mOHM | 60V | 10.6A |  |  | 20V | 1UA | 2.5W AT 10.6A | 108 |  | Up to 5A |  | ARROW | 17nC | 864PF |  | YES | 4 ELEMENT
DMG4822SSDQ | 10V, 10A, 21mOHM | 30V | 10A |  |  | 25V | 1UA | 2.1W AT 10A | 88.4 |  | Good for upto 6A | F=10Khz | ARROW | 10.5nC | 478.9 PF |  | NO | 2 ELEMENT
IRF7470PbF | 10V, 10A - 13mOHM | 40v | 10A |  |  | 12V | 20ua | 1.3w at 10a | 50 |  | Good for 10A | F=10Khz | ARROW | 44NC | 3430PF |  | NO
SSFB3910L | 10V 6A, 13mOHM | 30V | 10A/ 8A(70C) |  |  | 20V | 1uA | 0.4W AT 6A | 62 |  |  |  | ARROW | 12nC | 900pF |  | NO | NO
NVMFD5C478N | 10V, 7.5A, 18mOHM | 40V | 9.8/6.8 AT 100C |  |  | 20V | 10uA | 1W AT 7.5A | 48 |  |  |  | ARROW | 6.3nC | 325PF |  | YES | 2 ELEMEMNT
NVMFD5C466N | 10V, 15A, 8.1mOHM | 40V | 14A/10A AT 100C |  |  | 20V | 10uA | 1.8W AT 15A | 49 |  |  |  | ARROW | 11nC | 650pF |  | YES | 2 ELEMNT
NTMFD5C466NL | 10V, 10A, 12.6mOHM | 40V | 10A AT 100 |  |  | 20V | 10uA | 1.26W AT 10A | 49 |  |  |  | ARROW | 1.5NC | 997PF |  | YES | 2 ELEMENT
AO4838 | 10V, 11A, 9.6mOHM | 30V | 9A AT 100C |  |  | 20V | 1UA | 1.16W AT 11A | 90 |  |  |  | ARROW | 22NC | 1300PF |  | NO | 2 ELEMENT
FDMD8280 | 10V, 11A, 8.2mOHM | 80V | 11A |  |  | 20V | 1UA | 0.9 AT 11A | 60 |  |  |  | ARROW | 44NC | 3050PF |  | YES | 2 ELEMENT
DRV8701
GATE DRIVE VOLTAGE |  |  |  |  |  | 9.5V

Sheet: Mosfet(p channel)
PARAMETERS/ Mosfet Part Number | RDS(ON) mOHM | VDS(V) | ID @100 Deg C | VGS-TH | Transconductance (siemens) | VGS-MAX | IDSS (uA) | P(DIS)-W (ILOAD^2 X RDS) | RTJA (c/w) | Vendors | Total gate charge (nC) | I/P Capacitance (pF) | SW Freq | Thermal Pad mm^2
NVMFS5A140PLZT1G | 4.2 | 40 | 20 @25 | 1.2 | 125 | 20 | 10 | 1.68 | 39 | Arrow | 136 | 7400 | na | 650
IRF7425TRPBF | 13 | 20 | 10 @100 | 1.2 | 44 | 12 | 25 | 1.3 | 50 | Arrow | 130 | 7980 | NA | NA
SQA405EJ-T1_GE3 | 50 | 40 | 10 @125 | 2 | 18 | 20 | 50 | 5 | 90 | Arrow | 33 | 1815 |  | 645
SISS65DN-T1-GE3 | 110 | 30 | 13.8@ 70 | 1 | 47 | 20 | 5 | 11 | 33 | Arrow | 126 | 4427 | NA | 645
SQJA37EP-T1_GE3 | 14.6 | 30 | 30@125 | 2 | 32 | 20 | 50 | 1.4 | 70 | Arrow | 100 | 4900 |  | 645
SISH625DN-T1-GE3 | 11 | 30 | 13.8@70 | 1 | 47 | 20 | 5 | 1.1 | 33 | Arrow | 126 | 4427 |  | na
CSD25310Q2T | 59 | 20 | 9.6 @100 | 0.85 | 34 | 20 | 1 | 5.43744 | 43 | Arrow | 4.7 | 655 |  | 645
IRF9388TRPBF | 11.9 | 30 | 9.6@70 | 1.8 | 20 | 25 | 150 | 1.1 | 50 | Arrow | 18 | 1680 |  | na
FDS4465 | 10.5 | 20 | 13.5 | 1.5 | 70 | 8 | 1 | 1 | 50 | Arrow |  | 8237 |  | 645 of 2oz
IRF9310TRPBF | 6.8 | 30 | 16@70 | 1.8 | 39 | 20 | 150 | 0.6 | 50 | LCSC | 58 | 5250 |  | NA
