Reflow-Soldering/AltiumDesigner/다운로드 리소스/Section-10+Documents/Mixed Signal Board Project - final/PDNAnalyzer_Output/Mixed Signal Board Project/PDN SIMULATION/Results-0/vias.csv

x | y | layer1 | layer2 | voltage1 | voltage2 | current
60.932 | 569.616 | TOP_LAYER | GND | 0.0114816 | 0.0114816 | 1.74069e-14
60.932 | 569.616 | GND | VCC | 0.0114816 | 0.0114816 | -6.31757e-14
60.932 | 569.616 | VCC | BOTTOM_LAYER | 0.0114816 | 0.0114816 | -5.22208e-14
111.201 | 1968.8 | TOP_LAYER | GND | 0.00863185 | 0.00863185 | 5.22208e-14
111.201 | 1968.8 | GND | VCC | 0.00863185 | 0.00863185 | -4.83899e-14
111.201 | 1968.8 | VCC | BOTTOM_LAYER | 0.00863185 | 0.00863185 | -3.48139e-14
130.568 | 1424.43 | TOP_LAYER | GND | 0.011389 | 0.011389 | 5.22208e-14
130.568 | 1424.43 | GND | VCC | 0.011389 | 0.011389 | -2.15066e-14
130.568 | 1424.43 | VCC | BOTTOM_LAYER | 0.011389 | 0.011389 | -0
147.773 | 1784.43 | TOP_LAYER | GND | 3.29894 | 3.29894 | 1.33685e-11
147.773 | 1784.43 | GND | VCC | 3.29894 | 3.29894 | 1.82376e-11
147.773 | 1784.43 | VCC | BOTTOM_LAYER | 3.29894 | 3.29894 | -8.91235e-12
191.568 | 510.432 | TOP_LAYER | GND | 0.0114875 | 0.0114875 | 5.22208e-14
191.568 | 510.432 | GND | VCC | 0.0114875 | 0.0114875 | 1.88183e-14
191.568 | 510.432 | VCC | BOTTOM_LAYER | 0.0114875 | 0.0114875 | 3.48139e-14
204.506 | 1321.08 | TOP_LAYER | GND | 3.29888 | 3.29888 | 1.24099e-11
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
