Reflow-Soldering/AltiumDesigner/다운로드 리소스/Section-10+Documents/Mixed Signal Board Project - final/PDNAnalyzer_Output/Mixed Signal Board Project/PDN SIMULATION/Results-0/vcomp2id.csv

vrefdes | id
VCOMP0 | 0
VCOMP1 | 1
VCOMP2 | 2
VCOMP3 | 3
VCOMP4 | 4
VCOMP5 | 5
VCOMP6 | 6
VCOMP7 | 7
