Reflow-Soldering/AltiumDesigner/다운로드 리소스/Section-10+Documents/Mixed Signal Board Project - final/PDNAnalyzer_Output/Mixed Signal Board Project/PDN SIMULATION/Results-0/vpins.csv

refdes | pin | voltage | current | rpin
VCOMP0 | VCOMP0-0 | 11.9938 | 6.1601 | 0
VCOMP0 | VCOMP0-1 | 0 | -6.1601 | 0
VCOMP1 | VCOMP1-0 | 11.9332 | -1.02736 | 0.05
VCOMP1 | VCOMP1-1 | 11.9311 | -0.985539 | 0.05
VCOMP1 | VCOMP1-2 | 11.9312 | -0.987098 | 0.05
VCOMP1 | VCOMP1-3 | 0.0160381 | 3 | 0.05
VCOMP2 | VCOMP2-0 | 11.9314 | -1.04066 | 0.05
VCOMP2 | VCOMP2-1 | 11.9283 | -0.978711 | 0.05
VCOMP2 | VCOMP2-2 | 11.9284 | -0.980626 | 0.05
VCOMP2 | VCOMP2-3 | 0.017455 | 3 | 0.05
VCOMP3 | VCOMP3-0 | 3.29885 | -0.01 | 16
VCOMP3 | VCOMP3-1 | 0.0113987 | 0.00249997 | 16
VCOMP3 | VCOMP3-2 | 0.0114003 | 0.00249987 | 16
VCOMP3 | VCOMP3-3 | 0.0113972 | 0.00250006 | 16
VCOMP3 | VCOMP3-4 | 0.0113966 | 0.0025001 | 16
VCOMP4 | VCOMP4-0 | 3.29853 | -0.0299241 | 2.96296
VCOMP4 | VCOMP4-1 | 3.2988 | -0.0300173 | 2.96296
VCOMP4 | VCOMP4-2 | 3.2988 | -0.0300171 | 2.96296
VCOMP4 | VCOMP4-3 | 3.29888 | -0.0300448 | 2.96296
VCOMP4 | VCOMP4-4 | 3.29874 | -0.0299969 | 2.96296
VCOMP4 | VCOMP4-5 | 0.00968718 | 0.0372675 | 2.96296
VCOMP4 | VCOMP4-6 | 0.00818463 | 0.0377747 | 2.96296
VCOMP4 | VCOMP4-7 | 0.00852806 | 0.0376587 | 2.96296
VCOMP4 | VCOMP4-8 | 0.00959336 | 0.0372992 | 2.96296
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
