Reflow-Soldering/AltiumDesigner/Mixed Signal Board Design Project/Mixed Signal Board Design Project.pdf

REVISION | DESCRIPTION | DATE | APPROVED | REV. SHT. DWG. NO. 1

# STM32F103

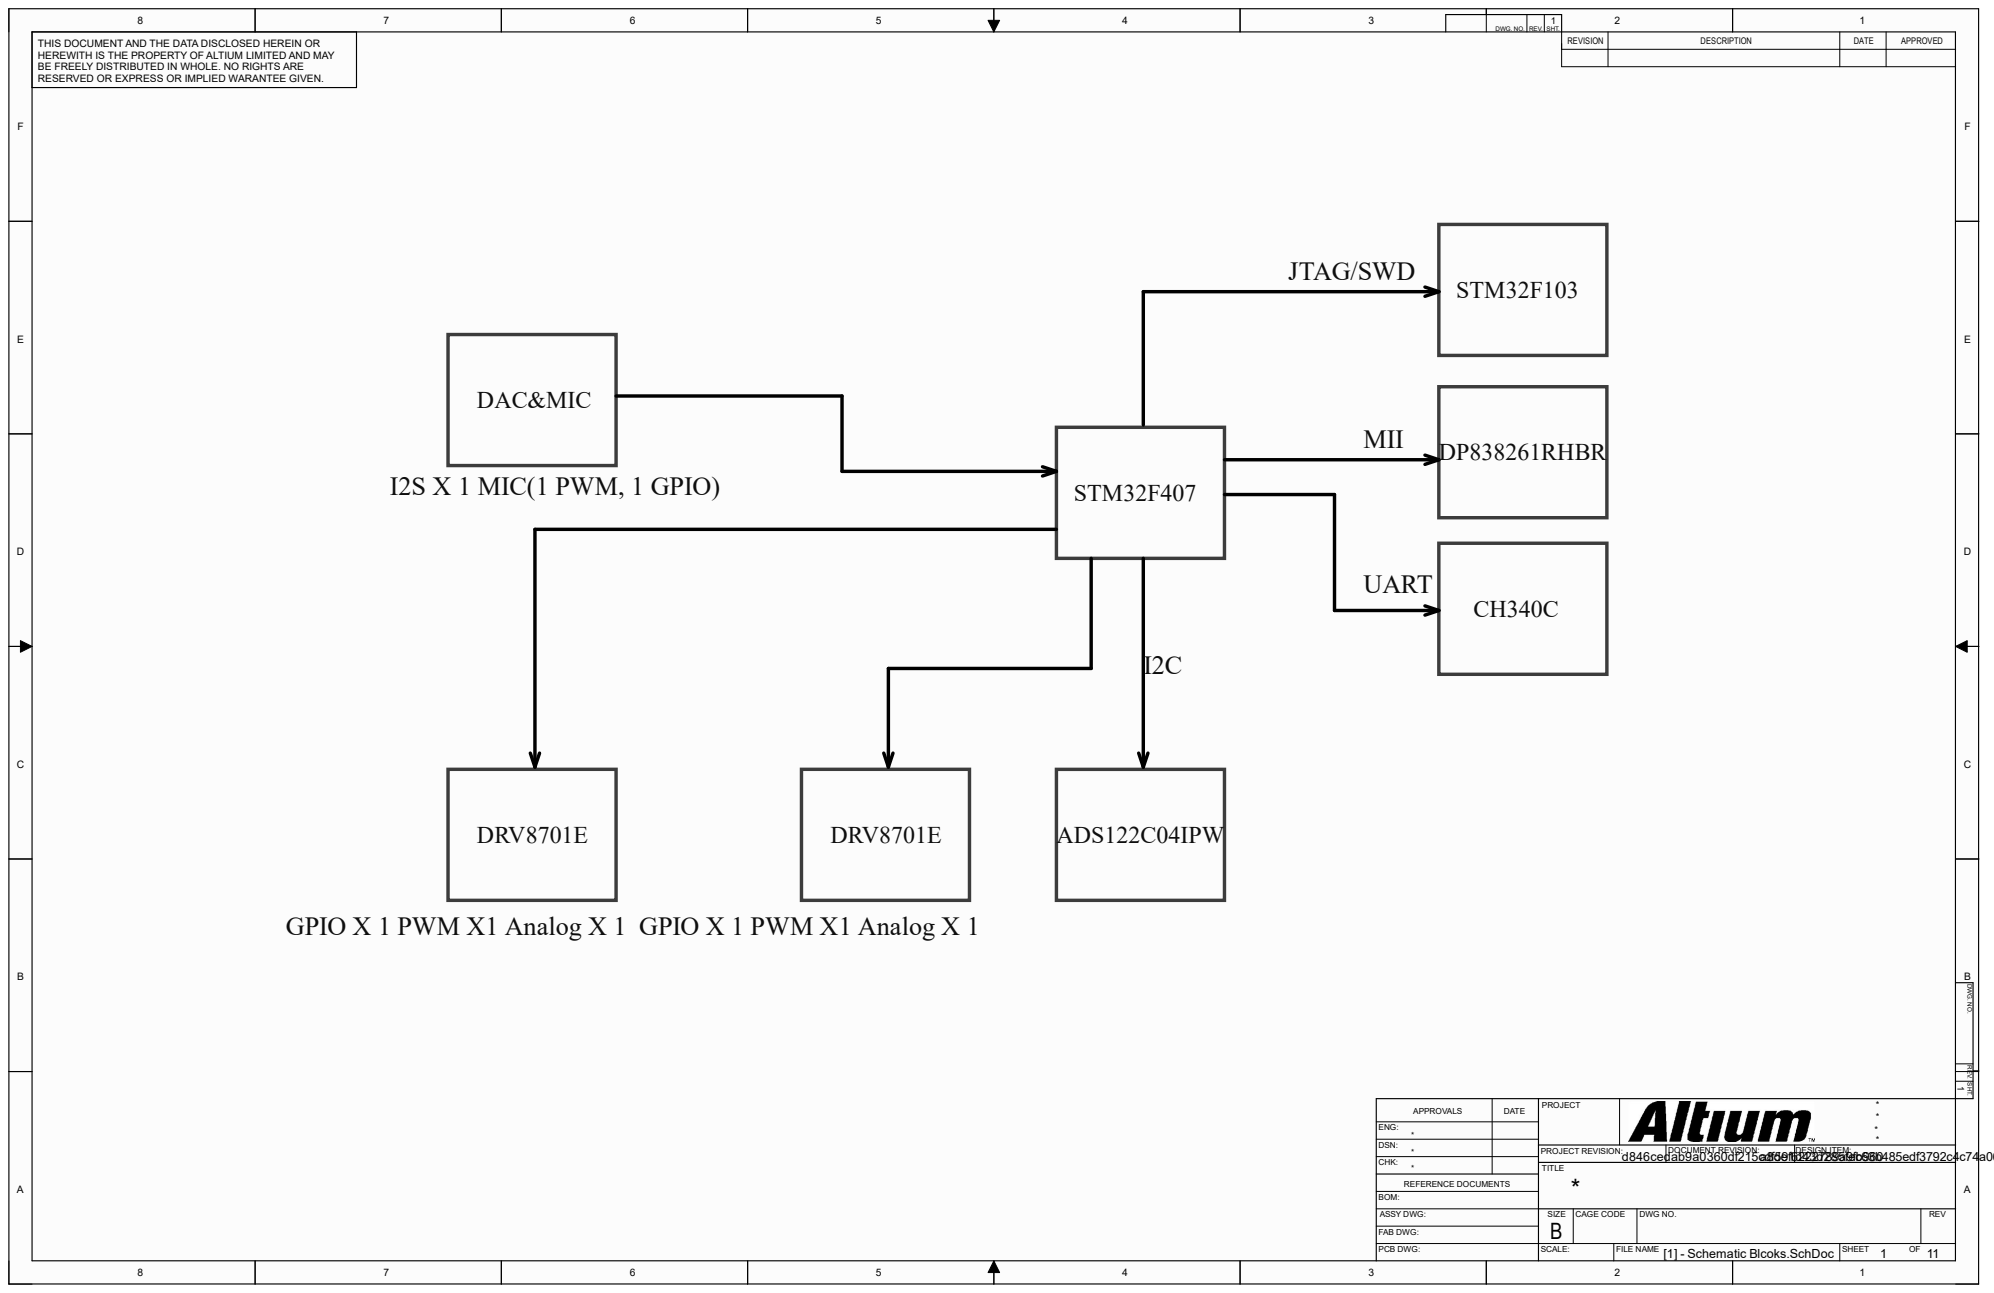
[picture p1: page 1]
[1] - Schematic Blcoks.SchDoc; TITLE; SIZE; DWG NO.; FILE NAME; SHEET; REV; SCALE:; CAGE CODE; REFERENCE DOCUMENTS; BOM:; ASSY DWG:; FAB DWG:; PCB DWG:; PROJECT REVISION:; DOCUMENT REVISION:; DESIGN ITEM: d846cedab9a0360df215cdf59f6222789a9fb960 a8de1d43d285fec63b485edf3792c4c74a06e07a; STM32F407; DP838261RHBR MII; UART; ADS122C04IPW; DRV8701E; DAC&MIC

THIS DOCUMENT AND THE DATA DISCLOSED HEREIN OR HEREWITH IS THE PROPERTY OF ALTIUM LIMITED AND MAY BE FREELY DISTRIBUTED IN WHOLE. NO RIGHTS ARE RESERVED OR EXPRESS OR IMPLIED WARANTEE GIVEN. | JTAG/SWD

DWG. NO. | REV. | SHT.

I2S X 1 MIC(1 PWM, 1 GPIO)

GPIO X 1 PWM X1 Analog X 1

APPROVALS | DATE | PROJECT | * *

ENG: *
DSN: *
CHK: *

REVISION | DESCRIPTION | DATE | APPROVED | REV. SHT. DWG. NO. 2
Input Power Conn | Motor-Driver-1

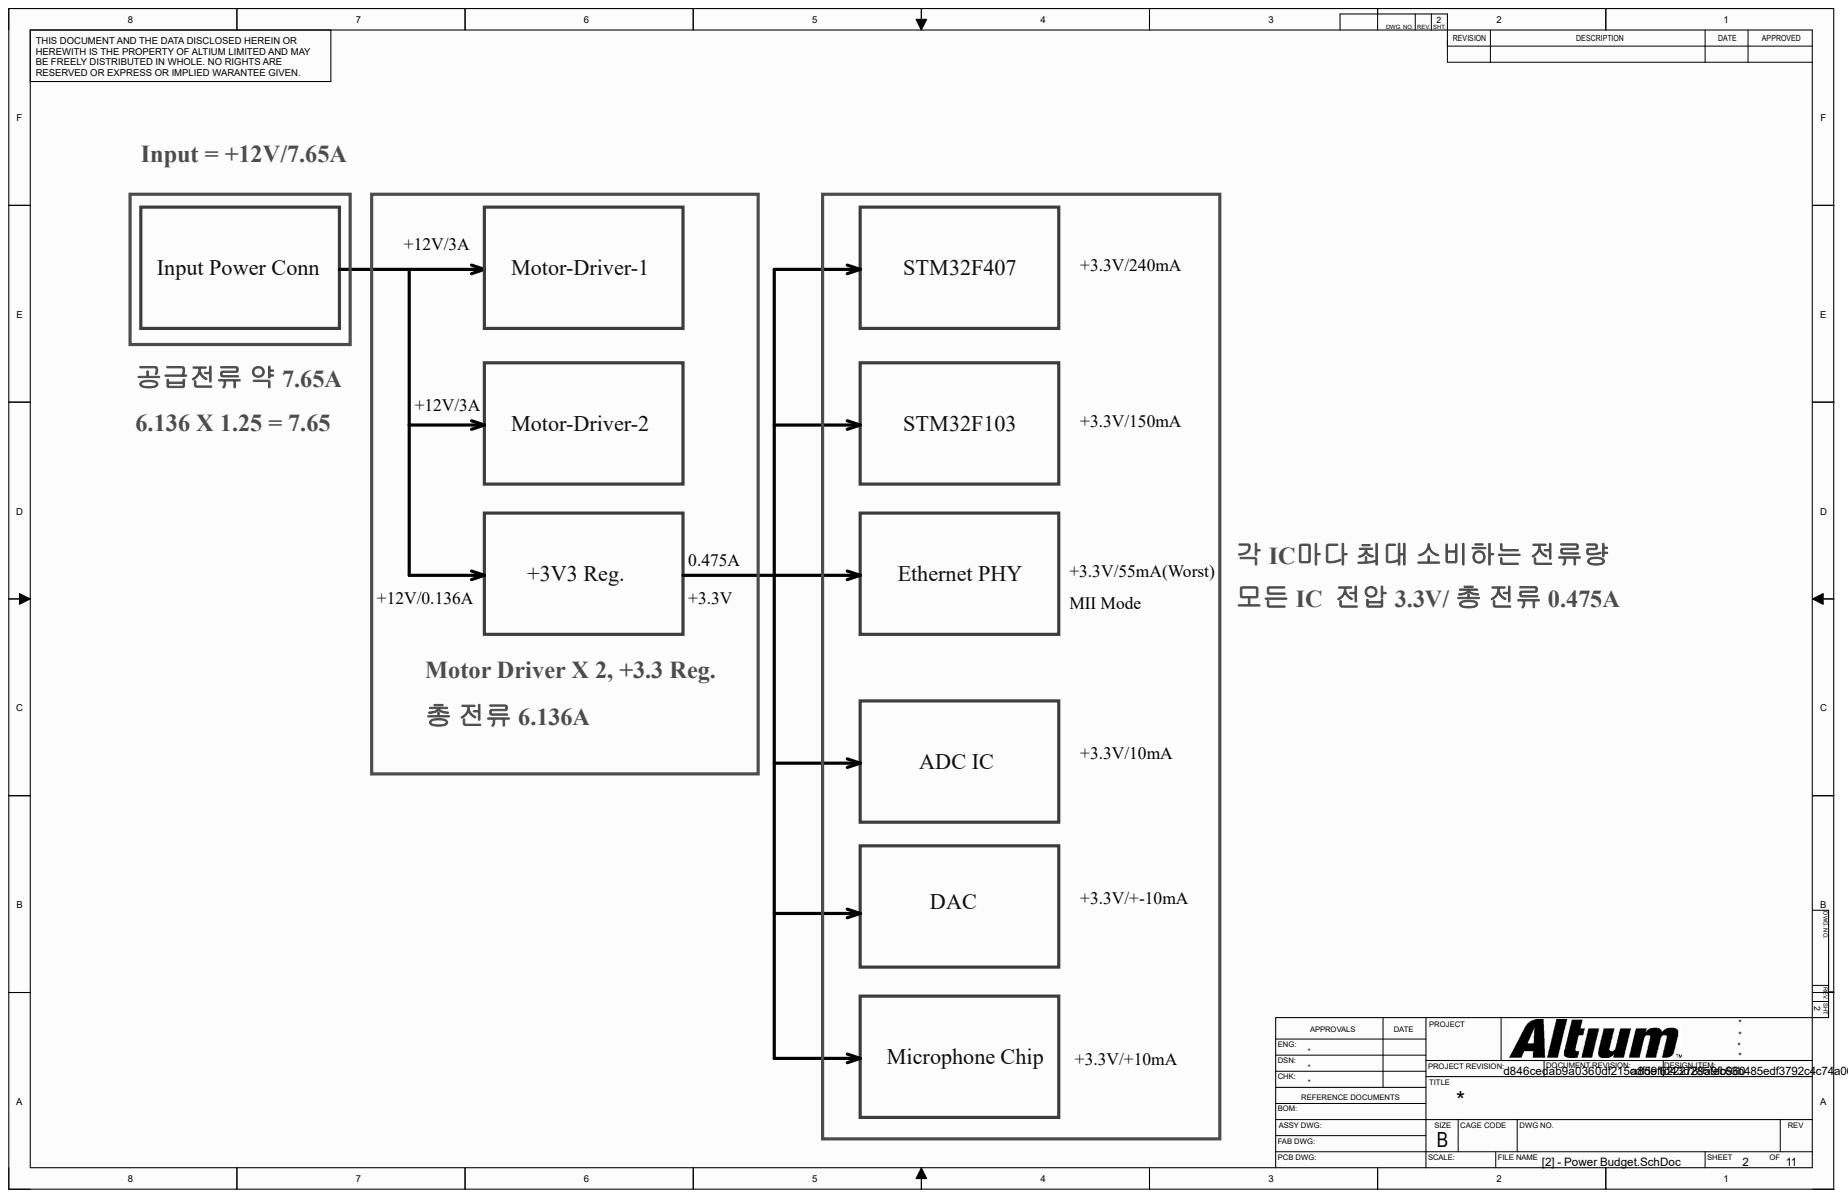
[picture p2: page 2]
[2] - Power Budget.SchDoc; TITLE; SIZE; DWG NO.; REV; CAGE CODE; REFERENCE DOCUMENTS; BOM:; ASSY DWG:; PROJECT REVISION:; DOCUMENT REVISION:; DESIGN ITEM: d846cedab9a0360df215cdf59f6222789a9fb960 a8de1d43d285fec63b485edf3792c4c74a06e07a; Motor-Driver-2; +3V3 Reg.; STM32F407; STM32F103; Ethernet PHY; ADC IC; DAC; Microphone Chip; +3.3V/55mA(Worst); MII Mode; 공급전류 약 7.65A; Input = +12V/7.65A

BE FREELY DISTRIBUTED IN WHOLE. NO RIGHTS ARE
RESERVED OR EXPRESS OR IMPLIED WARANTEE GIVEN.

각 IC마다 최대 소비하는 전류량

Motor Driver X 2, +3.3 Reg.

APPROVALS | DATE | PROJECT | * *

ENG: *
DSN: *
CHK: *

REVISION | DESCRIPTION | DATE | APPROVED | REV. SHT. DWG. NO. 3

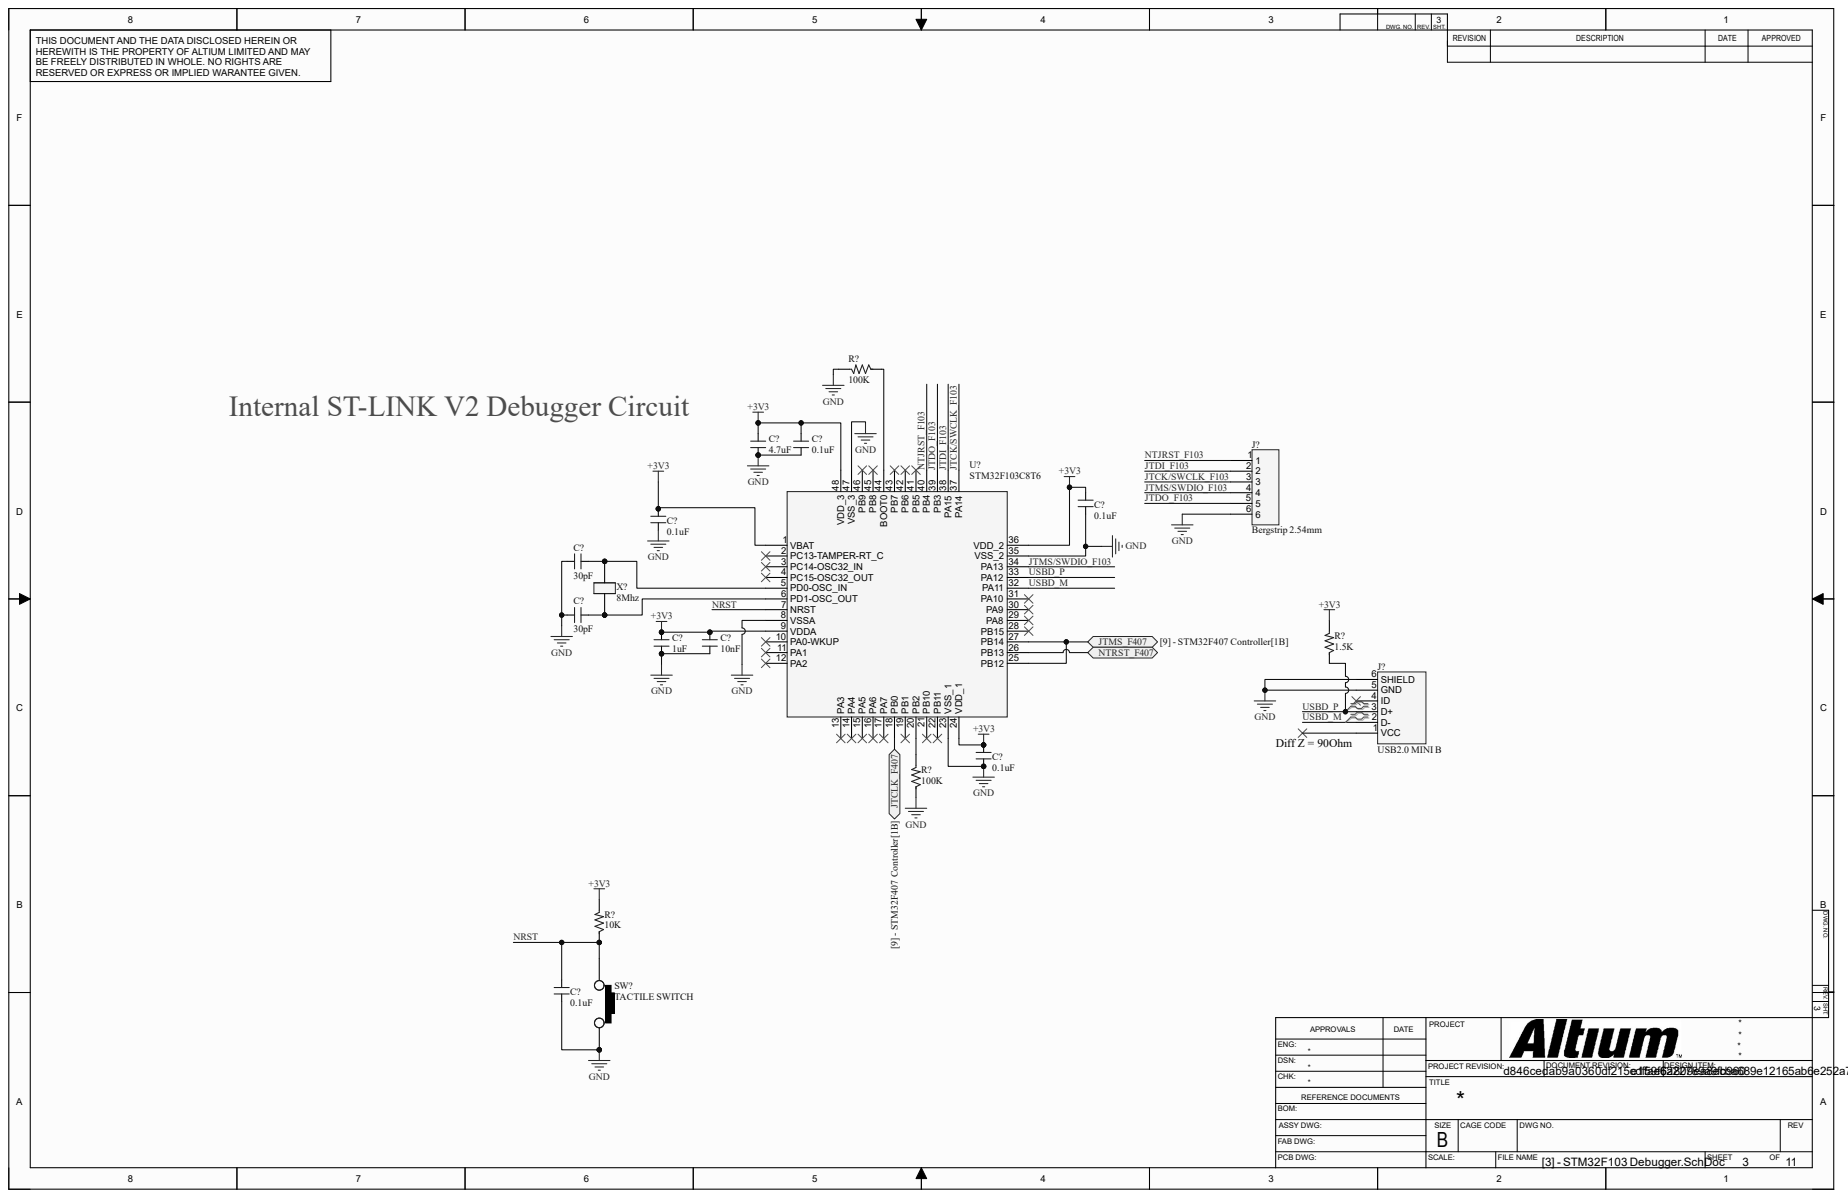
[picture p3: page 3]
[3] - STM32F103 Debugger.SchDoc; TITLE; SIZE; DWG NO.; REV; CAGE CODE; REFERENCE DOCUMENTS; BOM:; ASSY DWG:; PROJECT REVISION:; DOCUMENT REVISION:; DESIGN ITEM: d846cedab9a0360df215cdf59f6222789a9fb960 e1fae6a809ea8ecba689e12165ab6e252a7ca930; VBAT 1 PC13-TAMPER-RT_C 2 PC14-OSC32_IN 3 PC15-OSC32_OUT 4 PD0-OSC_IN 5 PD1-OSC_OUT 6 NRST 7 VSSA 8 VDDA 9 PA0-WKUP 10 PA1 11; PA³ 13 PA⁴ 14 PA⁵ 15 PA⁶ 16 PA⁷ 17 PB⁰ 18 PB¹ 19 PB² 20 PB¹⁰ 21 PB¹¹ 22 VSS_1 23 VDD_1 24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

BE FREELY DISTRIBUTED IN WHOLE. NO RIGHTS ARE
RESERVED OR EXPRESS OR IMPLIED WARANTEE GIVEN.

Internal ST-LINK V2 Debugger Circuit

PB12 25 VDD_3 48 VSS_3 47 PB⁹ ⁴⁶ PB⁸ ⁴⁵ BOOT0 44 PB⁷ ⁴³ PB⁶ ⁴² PB⁵ ⁴¹ PB⁴ ⁴⁰ PB³ ³⁹ PA¹⁵ ³⁸ PA¹⁴ ³⁷

APPROVALS | DATE | PROJECT | * *

ENG: *
DSN: *
CHK: *

REVISION | DESCRIPTION | DATE | APPROVED | REV. SHT. DWG. NO. 4

# 3K3 A K

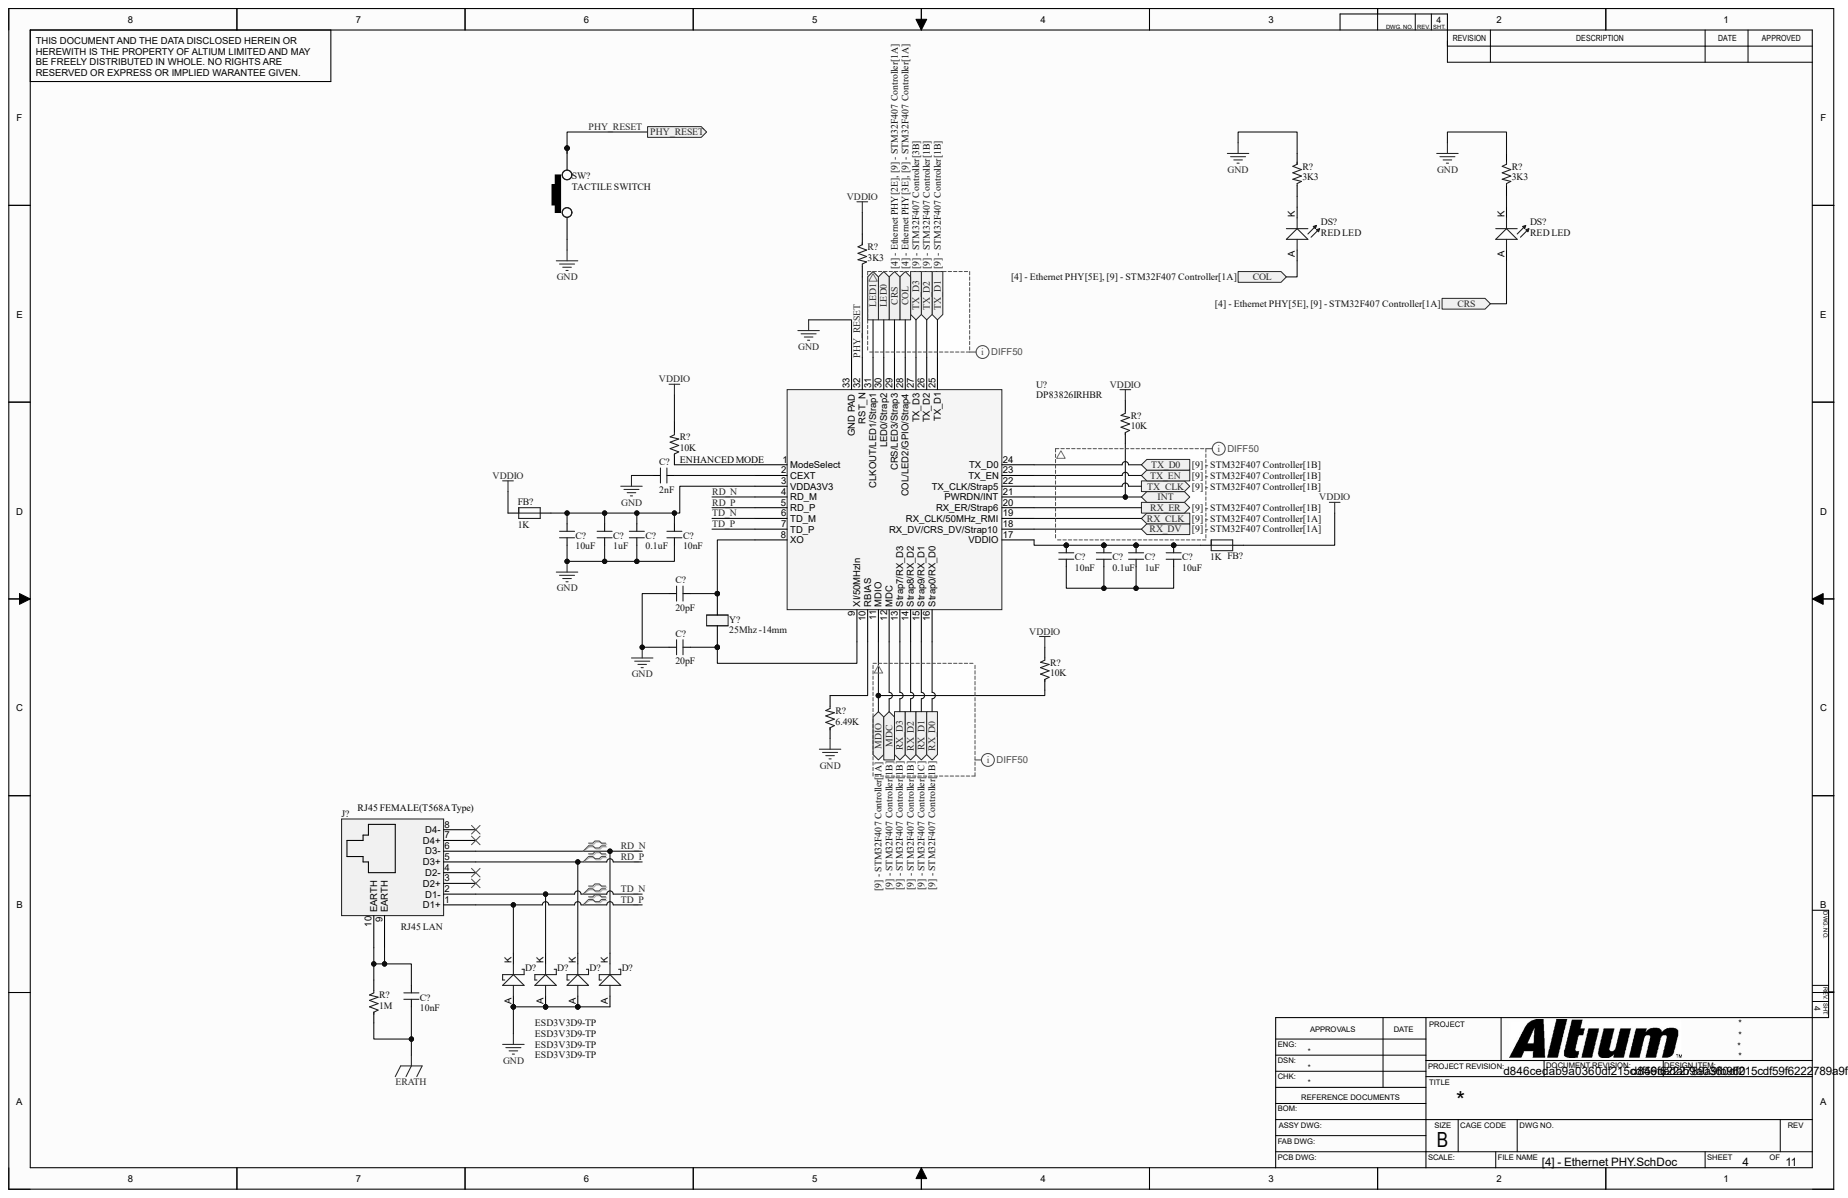
[picture p4: page 4]
[4] - Ethernet PHY.SchDoc; TITLE; SIZE; DWG NO.; REV; CAGE CODE; REFERENCE DOCUMENTS; BOM:; ASSY DWG:; PROJECT REVISION:; DOCUMENT REVISION:; DESIGN ITEM: d846cedab9a0360df215cdf59f6222789a9fb960 d846cedab9a0360df215cdf59f6222789a9fb960; ModeSelect 1 CEXT 2 VDDA3V3 3 RD_M 4 RD_P 5 TD_M 6 TD_P 7; XI/50MHzIn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

BE FREELY DISTRIBUTED IN WHOLE. NO RIGHTS ARE
RESERVED OR EXPRESS OR IMPLIED WARANTEE GIVEN.

TX_D0 [9] - STM32F407 Controller[1B] TX_D¹ [9] - STM³²F⁴⁰⁷ Controller[1B] TX_D² [9] - STM³²F⁴⁰⁷ Controller[1B] TX_D³ [9] - STM³²F⁴⁰⁷ Controller[3B] COL [4] - Ethernet PHY[3E], [9] - STM³²F⁴⁰⁷ Controller[1A] CRS [4] - Ethernet PHY[2E], [9] - STM³²F⁴⁰⁷ Controller[1A] LED¹ LED⁰

9 RBIAS 10 MDIO 11 MDC 12 Strap7/RX_D3 13 Strap8/RX_D2 14 Strap9/RX_D1 15 Strap0/RX_D0 16

VDDIO MDIO [9] - STM³²F⁴⁰⁷ Controller[1A] MDC [9] - STM³²F⁴⁰⁷ Controller[1B] RX_D³ [9] - STM³²F⁴⁰⁷ Controller[1B] RX_D² [9] - STM³²F⁴⁰⁷ Controller[1B] RX_D¹ [9] - STM³²F⁴⁰⁷ Controller[1C] RX_D⁰ [9] - STM³²F⁴⁰⁷ Controller[1B]

APPROVALS | DATE | PROJECT | * *

ENG: *
DSN: *
CHK: *

REVISION | DESCRIPTION | DATE | APPROVED | REV. SHT. DWG. NO. 5

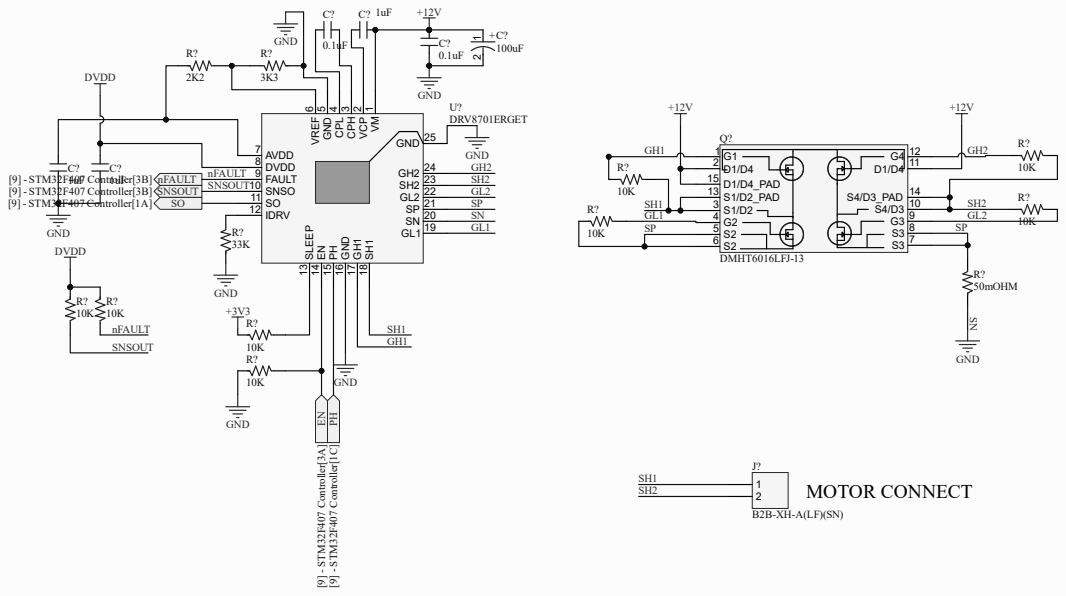
[picture p5: page 5]
[5] - Motor Driver Schematic.SchDoc 5; TITLE; SIZE; DWG NO.; REV; CAGE CODE; REFERENCE DOCUMENTS; BOM:; ASSY DWG:; PROJECT REVISION:; DOCUMENT REVISION:; DESIGN ITEM: d846cedab9a0360df215cdf59f6222789a9fb960 e1fae6a809ea8ecba689e12165ab6e252a7ca930 VM; 1 VCP; 2 CPH; 3 CPL; 4 GND; 5 VREF; AVDD 7 DVDD 8 FAULT 9 SNSO 10 SO 11; IDRV 12; SLEEP 13 EN 14 PH 15 GND 16 GH¹ 17 SH¹ 18; GND 25; U? DRV8701ERGET; GND; [9] - STM32F407 Controller[3B] nFAULT [9] - STM32F407 Controller[3B] SNSOUT; DVDD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

BE FREELY DISTRIBUTED IN WHOLE. NO RIGHTS ARE
RESERVED OR EXPRESS OR IMPLIED WARANTEE GIVEN.

APPROVALS | DATE | PROJECT | * *

ENG: *
DSN: *
CHK: *

REVISION | DESCRIPTION | DATE | APPROVED | REV. SHT. DWG. NO. 6

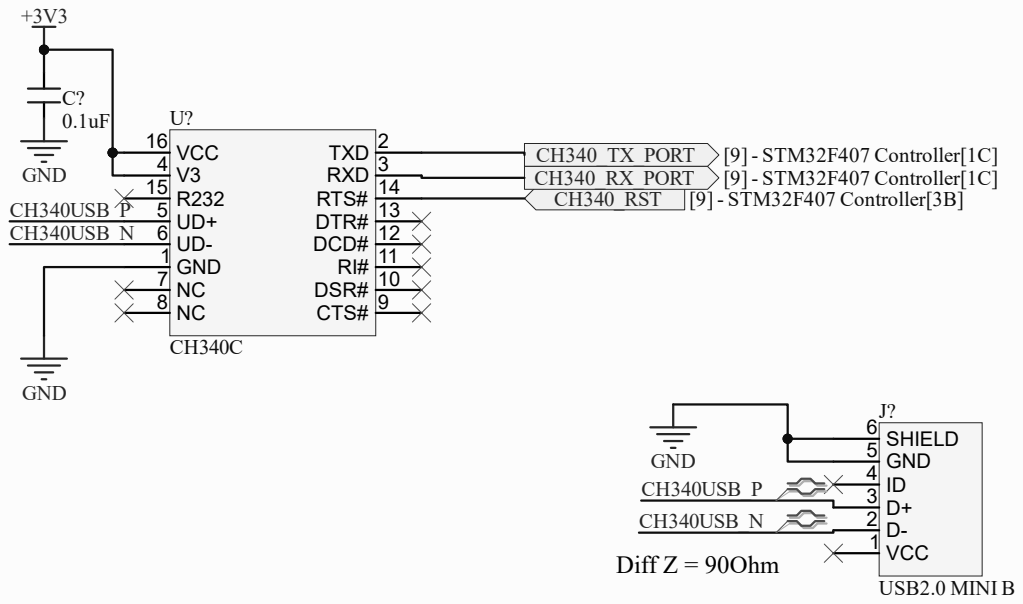
[picture p6: page 6]
[6] - CH340C.SchDoc; TITLE; SIZE; DWG NO.; REV; CAGE CODE; REFERENCE DOCUMENTS; BOM:; ASSY DWG:; PROJECT REVISION:; DOCUMENT REVISION:; DESIGN ITEM: d846cedab9a0360df215cdf59f6222789a9fb960 e1fae6a809ea8ecba689e12165ab6e252a7ca930; GND 1; TXD 2 RXD 3 V3 4; CTS# 9; DSR# 10 RI# 11 DCD# 12 DTR# 13 RTS# 14 R232 15; VCC 16; GND; GND CH340USB_P CH340USB_N; CH340_RST [9] - STM32F407 Controller[3B]; VCC 1; GND 5; SHIELD 6; USB2.0 MINI B; CH340_TX_PORT; [9] - STM32F407 Controller[1C]; CH340_RX_PORT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

BE FREELY DISTRIBUTED IN WHOLE. NO RIGHTS ARE
RESERVED OR EXPRESS OR IMPLIED WARANTEE GIVEN.

APPROVALS | DATE | PROJECT | * *

ENG: *
DSN: *
CHK: *

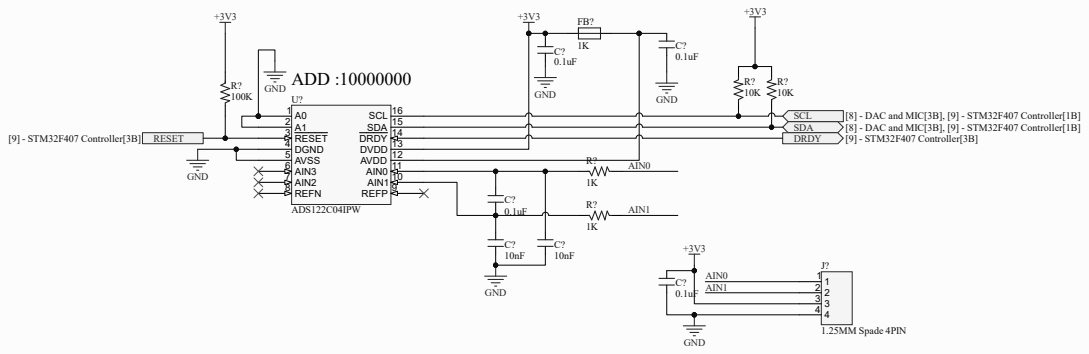
[picture p7: page 7]
TITLE :; SHEET; REV :; BOM No. :; DRAWN BY :; CHECKED BY :; APPROVED BY :; A0 1 A1 2 RESET 3 DGND 4 AVSS 5 AIN3 6 AIN2 7; REFN 8; REFP 9; ADS122C04IPW; GND; [9] - STM32F407 Controller[3B] RESET; SCL; [8] - DAC and MIC[3B], [9] - STM32F407 Controller[1B]; SDA; DRDY; [9] - STM32F407 Controller[3B]; AIN0; AIN1; 1.25MM Spade 4PIN; AIN0 AIN1; ADD :10000000

AIN1 10 AIN0 11 AVDD 12 DVDD 13 DRDY 14 SDA 15 SCL 16

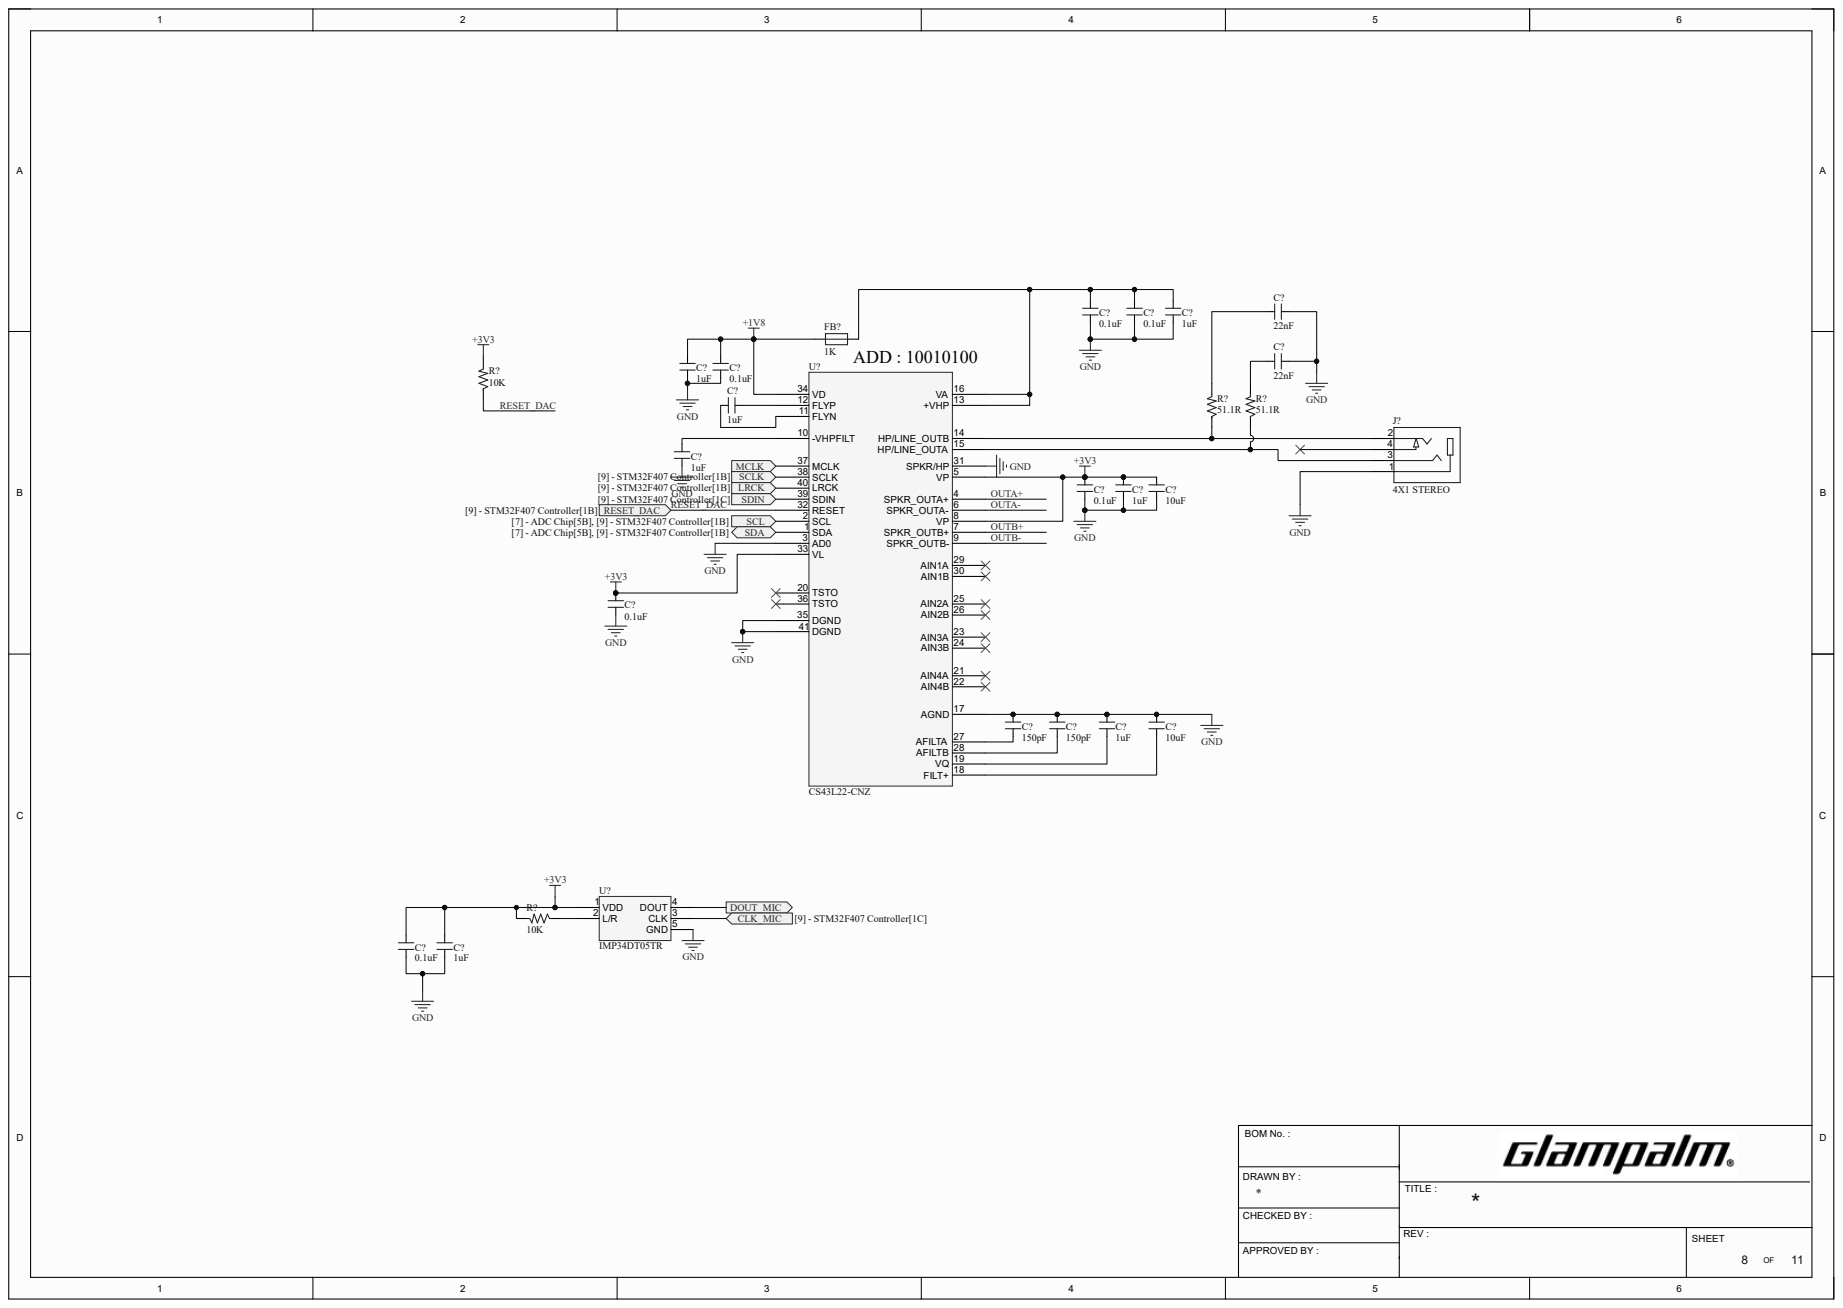
[picture p8: page 8]
TITLE :; BOM No. :; DRAWN BY : *; SDA 1; SCL 2; SPKR_OUTA+ 4; SPKR_OUTA- 6; SPKR_OUTB+ 7; SPKR_OUTB- 9; -VHPFILT 10; FLYN 11 FLYP 12; +VHP 13; HP/LINE_OUTB 14 HP/LINE_OUTA 15; AGND 17; FILT+ 18 VQ 19; TSTO 20; AIN4A 21 AIN4B 22; AIN3A 23 AIN3B 24; AIN2A 25 AIN2B 26; AFILTA 27 AFILTB 28; AIN1A 29 AIN1B 30; SPKR/HP 31; RESET 32; DGND 35; TSTO 36; MCLK 37 SCLK 38 SDIN 39 LRCK 40; DGND 41; CS43L22-CNZ; GND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

# PE7 38 PE8 39 PE9 40 PE10 41 PE11 42 PE12 43 PE13 44 PE14 45 PE15 46

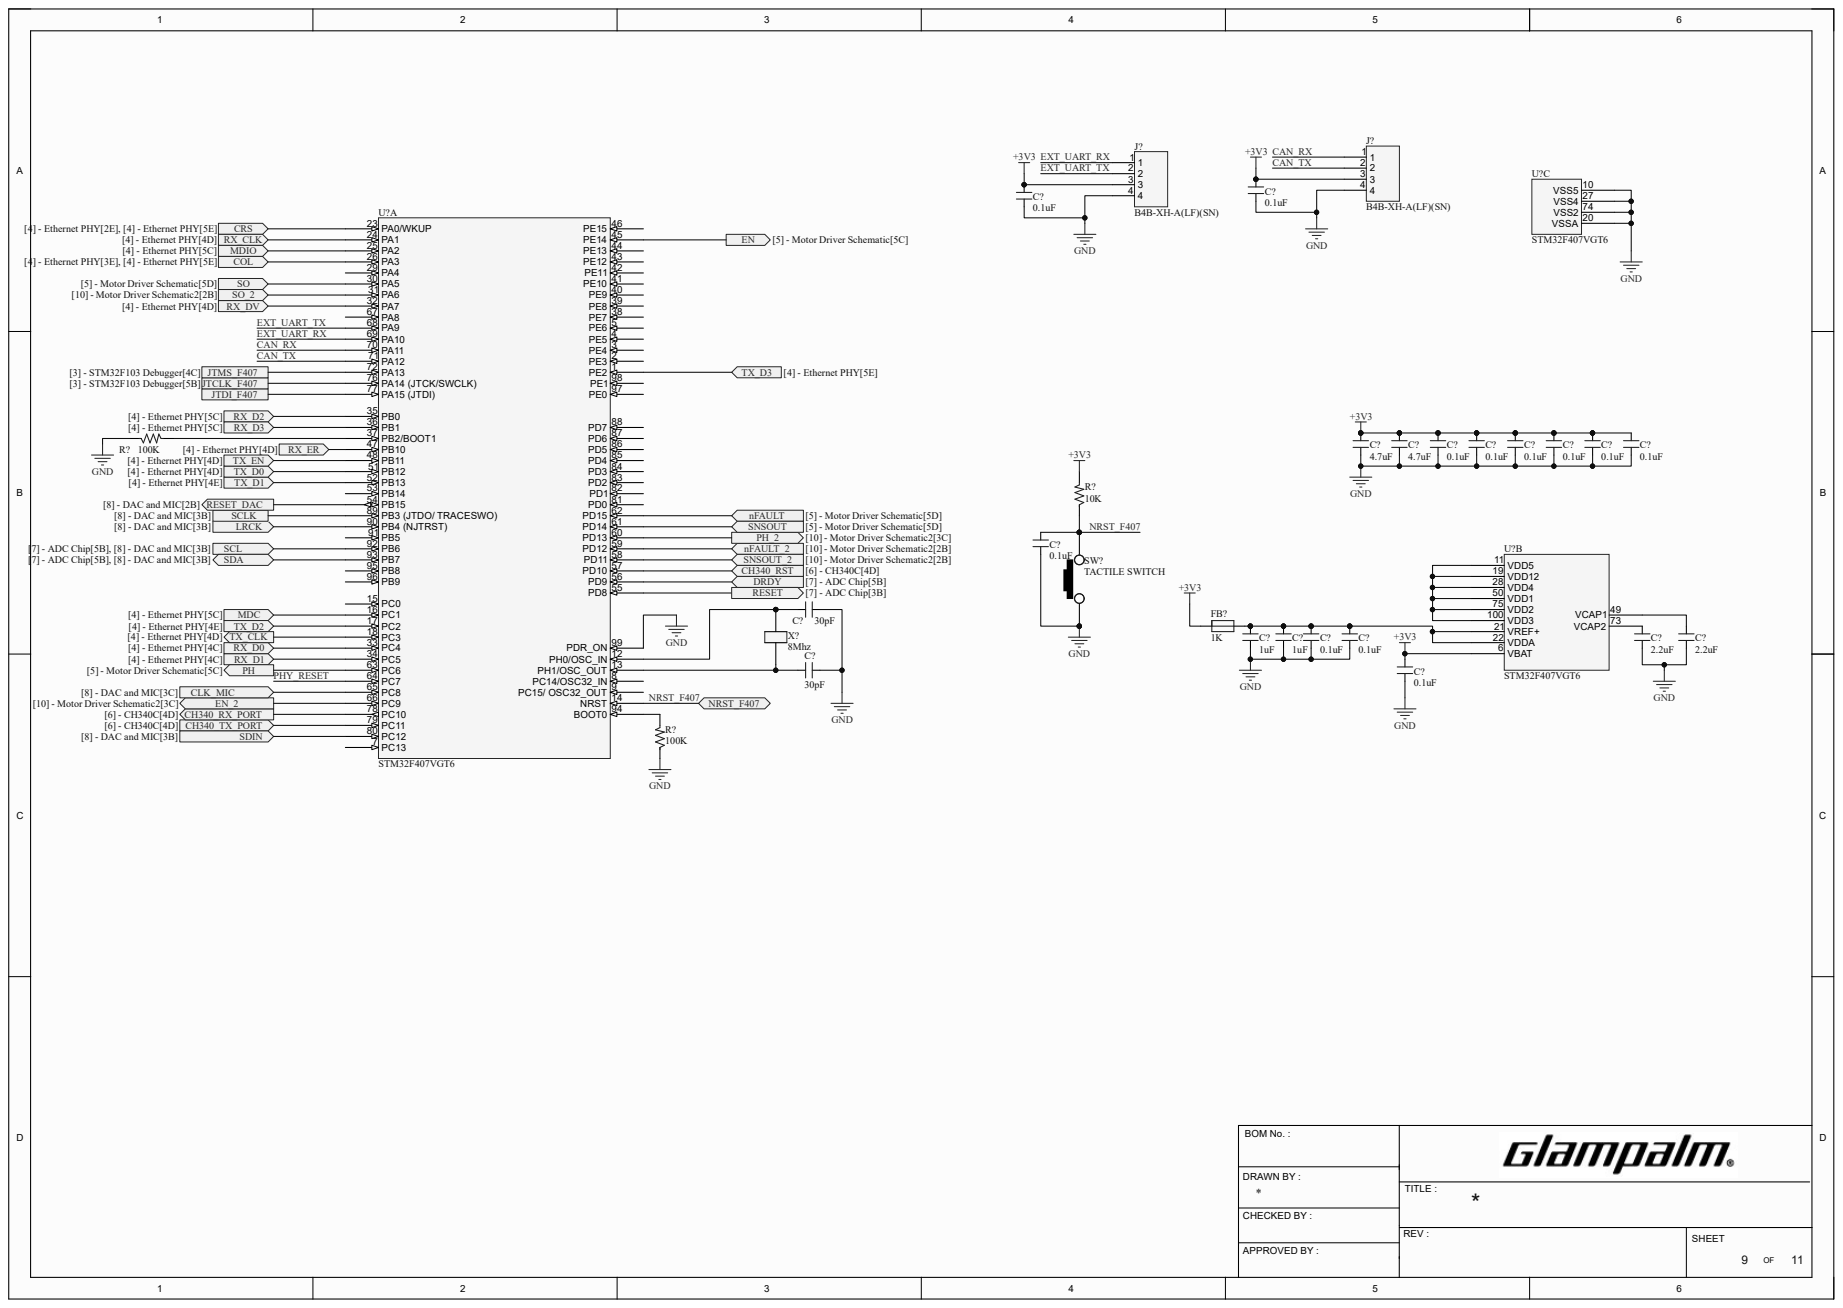
[picture p9: page 9]
TITLE :; BOM No. :; DRAWN BY : *; PC14/OSC32_IN 8 PC15/ OSC32_OUT 9; PH0/OSC_IN 12 PH1/OSC_OUT 13; NRST 14; PA0/WKUP 23 PA1 24 PA2 25 PA3 26 PA4 29 PA5 30 PA6 31 PA7 32; PB0 35 PB1 36 PB2/BOOT1 37 PB10 47 PB11 48 PB12 51 PB13 52 PB14 53 PB15 54; PA8 67 PA9 68 PA10 69 PA11 70 PA12 71 PA13 72 PA14 (JTCK/SWCLK) 76 PA15 (JTDI) 77; PB3 (JTDO/ TRACESWO) 89 PB4 (NJTRST) 90 PB5 91 PB6 92 PB7 93; BOOT0 94; PDR_ON 99; STM32F407VGT6; VDD5 11 VDD12 19 VDD4 28 VDD1 50 VDD2 75 VDD3 100 VREF+ 21 VDDA 22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

[4] - Ethernet PHY[4D] RX_CLK
[4] - Ethernet PHY[5C] MDIO

[8] - DAC and MIC[2B] RESET_DAC

[7] - ADC Chip[5B], [8] - DAC and MIC[3B] SCL
[7] - ADC Chip[5B], [8] - DAC and MIC[3B] SDA

[8] - DAC and MIC[3C] CLK_MIC

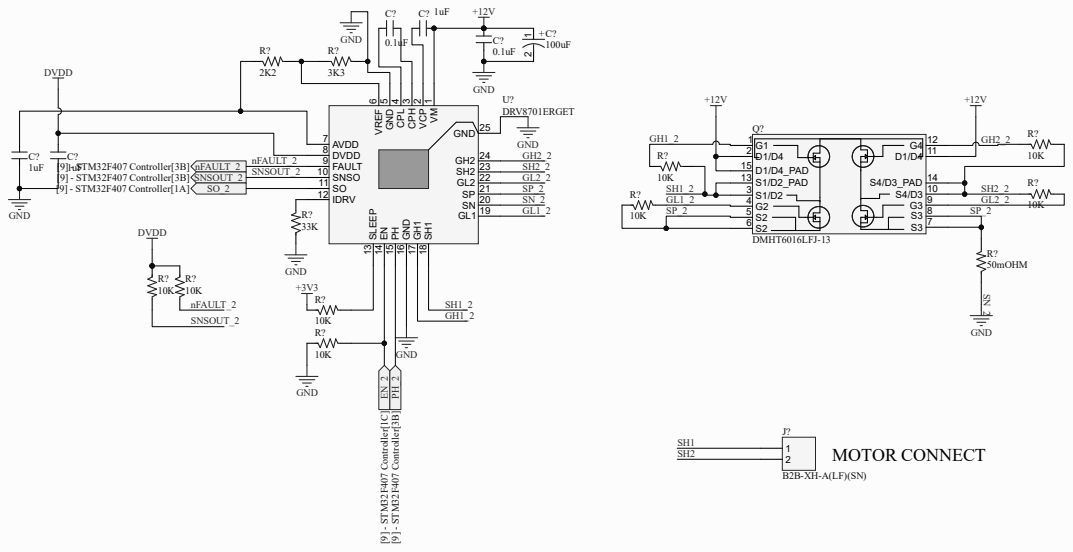
[picture p10: page 10]
TITLE :; BOM No. :; DRAWN BY :; 1 VCP; 2 CPH; 3 CPL; 4 GND; 5 VREF; AVDD 7 DVDD 8 FAULT 9 SNSO 10 SO 11; IDRV 12; SLEEP 13 EN 14 PH 15 GND 16 GH¹ 17 SH¹ 18; GND 25; U? DRV8701ERGET; GND; [9] - STM32F407 Controller[3B] nFAULT_2 [9] - STM32F407 Controller[3B] SNSOUT_2; DVDD; nFAULT_2; SNSOUT_2; nFAULT_2 SNSOUT_2; [9] - STM32F407 Controller[1A]; EN_2 [9] - STM³²F⁴⁰⁷ Controller[1C] PH_2 [9] - STM³²F⁴⁰⁷ Controller[3B]; S4/D3_PAD 14 S1/D2_PAD 13 D1/D4_PAD 15; DMHT6016LFJ-13; R? 50mOHM; GNDSN_2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

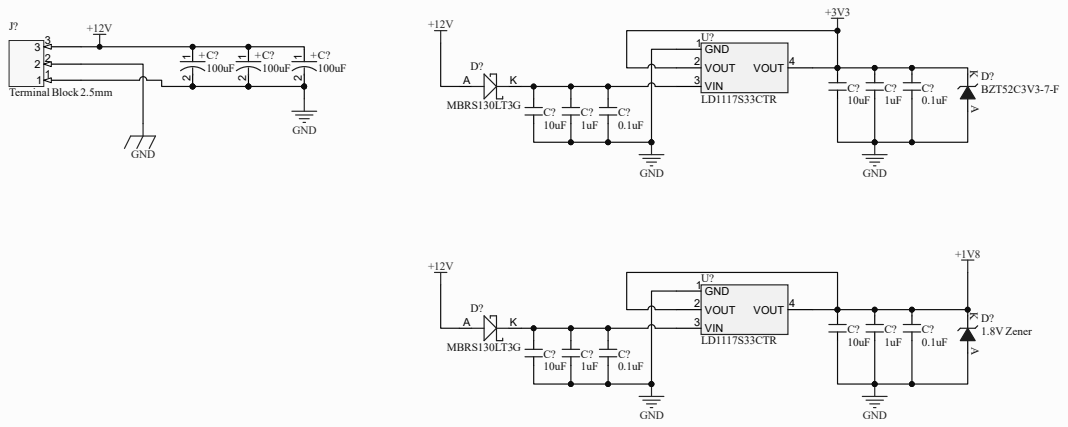
[picture p11: page 11]
TITLE :; BOM No. :; DRAWN BY : *; Terminal Block 2.5mm; GND; GND 1; VOUT 2; VIN 3; VOUT 4; LD1117S33CTR; MBRS130LT3G; D? BZT52C3V3-7-F; D? 1.8V Zener
