Reflow-Soldering/AltiumDesigner/(list of files, drawings)

Other design files:
EsteemPCB+Library/EsteemPCB Library/ESTEEMPCBLIB.SchLib
Mixed Signal Board Design Project/[1] - Schematic Blcoks.SchDoc
Mixed Signal Board Design Project/[2] - Power Budget.SchDoc
Mixed Signal Board Design Project/[3] - STM32F103 Debugger.SchDoc
Mixed Signal Board Design Project/[4] - Ethernet PHY.SchDoc
Mixed Signal Board Design Project/[5] - Motor Driver Schematic.SchDoc
Mixed Signal Board Design Project/[6] - CH340C.SchDoc
Mixed Signal Board Design Project/[7] - ADC Chip.SchDoc
Mixed Signal Board Design Project/[8] - DAC and MIC.SchDoc
Mixed Signal Board Design Project/[9] - STM32F407 Controller.SchDoc
Mixed Signal Board Design Project/[10] - Motor Driver Schematic2.SchDoc
Mixed Signal Board Design Project/[11] - Power Input and Regulators.SchDoc
Mixed Signal Board Design Project/Mixed Signal Board Design Project.PcbDoc
Mixed Signal Board Design Project/Mixed Signal Board Design Project.PrjPcb
Section-1+Documents/Mixed Signal Board Project/Mixed Signal Board Project.PrjPcb
Section-8+Documents/Mixed Signal Board Project - final/[1]- Schematic Blocks.SchDoc
Section-8+Documents/Mixed Signal Board Project - final/[2]-Power Budget.SchDoc
Section-8+Documents/Mixed Signal Board Project - final/[3]-STM32F103 Debugger.SchDoc
Section-8+Documents/Mixed Signal Board Project - final/[4]- Ethernet PHY.SchDoc
Section-8+Documents/Mixed Signal Board Project - final/[5]-Motor Driver Schematic.SchDoc
Section-8+Documents/Mixed Signal Board Project - final/[6]-CH340C.SchDoc
Section-8+Documents/Mixed Signal Board Project - final/[7]- ADC Chip.SchDoc
Section-8+Documents/Mixed Signal Board Project - final/[8]-DAC and MIC.SchDoc
Section-8+Documents/Mixed Signal Board Project - final/[9]-STM32F407 Controller.SchDoc
Section-8+Documents/Mixed Signal Board Project - final/[10]-Motor Driver-2.SchDoc
Section-8+Documents/Mixed Signal Board Project - final/[11]- Power Input and Regulators.SchDoc
Section-8+Documents/Mixed Signal Board Project - final/Mixed Signal Board Project.PcbDoc
Section-8+Documents/Mixed Signal Board Project - final/Mixed Signal Board Project.PrjPcb
다운로드 리소스/Section-10+Documents/Mixed Signal Board Project - final/[3]-STM32F103 Debugger.SchDoc
다운로드 리소스/Section-10+Documents/Mixed Signal Board Project - final/[4]- Ethernet PHY.SchDoc
다운로드 리소스/Section-10+Documents/Mixed Signal Board Project - final/[5]-Motor Driver Schematic.SchDoc
다운로드 리소스/Section-10+Documents/Mixed Signal Board Project - final/[6]-CH340C.SchDoc
다운로드 리소스/Section-10+Documents/Mixed Signal Board Project - final/[7]- ADC Chip.SchDoc
다운로드 리소스/Section-10+Documents/Mixed Signal Board Project - final/[8]-DAC and MIC.SchDoc
다운로드 리소스/Section-10+Documents/Mixed Signal Board Project - final/[9]-STM32F407 Controller.SchDoc
다운로드 리소스/Section-10+Documents/Mixed Signal Board Project - final/[10]-Motor Driver-2.SchDoc
다운로드 리소스/Section-10+Documents/Mixed Signal Board Project - final/[11]- Power Input and Regulators.SchDoc
다운로드 리소스/Section-10+Documents/Mixed Signal Board Project - final/Mixed Signal Board Project.PcbDoc
다운로드 리소스/Section-10+Documents/Mixed Signal Board Project - final/Mixed Signal Board Project.PrjPcb
