Reflow-Soldering/AltiumDesigner/Git_Altium_Designer.ioc

Mcu.UserName=STM32F407VGTx
PA0-WKUP.Signal=ETH_CRS
PA1.Signal=ETH_RX_CLK
PA10.Signal=USART1_RX
PA11.Signal=CAN1_RX
PA12.Signal=CAN1_TX
PA13.Signal=SYS_JTMS-SWDIO
PA14.Signal=SYS_JTCK-SWCLK
PA2.Signal=ETH_MDIO
PA3.Signal=ETH_COL
PA4.Signal=I2S3_WS
PA5.GPIO_Label=SOMOT1
PA5.Signal=ADCx_IN5
PA6.GPIO_Label=SOMOT2
PA6.Signal=ADCx_IN6
PA7.Signal=ETH_RX_DV
PA9.Signal=USART1_TX
PB0.Signal=ETH_RXD2
PB1.Signal=ETH_RXD3
PB11.Signal=ETH_TX_EN
PB12.Signal=ETH_TXD0
PB13.Signal=ETH_TXD1
PB15.GPIO_Label=DAC_RST
PB15.Signal=GPIO_Output
PB3.Signal=I2S3_CK
PB4.Signal=I2S3_ext_SD
PB5.Signal=I2S3_SD
PB6.Signal=I2C1_SCL
PB7.Signal=I2C1_SDA
PC1.Signal=ETH_MDC
PC10.Signal=UART4_TX
PC11.Signal=UART4_RX
PC2.Signal=ETH_TXD2
PC3.Signal=ETH_TX_CLK
PC4.Signal=ETH_RXD0
PC5.Signal=ETH_RXD1
PC6.GPIO_Label=MOT1PH
PC6.Signal=GPIO_Output
PC7.GPIO_Label=PHY_RESET
PC7.Signal=GPIO_Output
PC8.Signal=S_TIM3_CH3
PC9.Signal=S_TIM3_CH4
PD10.GPIO_Label=CH340_RST
PD10.Signal=GPIO_Output
PD11.GPIO_Label=SNSOMOT2
PD11.Signal=GPIO_Input
PD12.GPIO_Label=FAULTMOT2
PD12.Signal=GPIO_Input
PD13.GPIO_Label=MOT2PH
PD13.Signal=GPIO_Output
PD14.GPIO_Label=SNSOMOT1
PD14.Signal=GPIO_Input
PD15.GPIO_Label=FAULTMOT1
PD15.Signal=GPIO_Input
PD8.GPIO_Label=ADC_RST
PD8.Signal=GPIO_Output
PD9.GPIO_Label=ADC_DRDY
PD9.Signal=GPIO_Input
PE14.Signal=S_TIM1_CH4
PE2.Signal=ETH_TXD3
