Reflow-Soldering/AltiumDesigner/(commit log)

2025-08-01 8회차 시작임
    [프로젝트 사양서.xlsx]
2025-08-01 수정부 추가
2025-08-04 3강 완료 - 디버거
    [ADCs Criterias .xlsx, Component Checklist.xlsx, Component Naming Convention.xlsx, MOSFET PARAMETERS.xlsx, Mixed Signal Board Design Project.PrjPcb, Project Discussion.xlsx, Project+Discussion.xlsx, [1] - Schematic Blcoks.SchDoc]
2025-08-05 4일차 완료
    [Mixed Signal Board Project.PrjPcb, [1]- Schematic Blocks.SchDoc, [2]-Power Budget.SchDoc, [3] - STM32F103 Debugger.SchDoc, [3]-STM32F103 Debugger.SchDoc, [4] - Ethernet PHY.SchDoc, [4]- Ethernet PHY.SchDoc, 프로젝트 사양서.xlsx]
2025-08-07 5일차 완료
    [Mixed Signal Board Design Project.PcbDoc, Mixed Signal Board Design Project.PrjPcb, Mixed Signal Board Project.PcbDoc, Mixed Signal Board Project.PrjPcb, [10] - Motor Driver Schematic2.SchDoc, [10]-Motor Driver-2.SchDoc, [11] - Power Input and Regulators.SchDoc, [11]- Power Input and Regulators.SchDoc]
2025-08-07 아 저장 안하고 올려서 다시 올림
    [Mixed Signal Board Design Project.PrjPcb, [4] - Ethernet PHY.SchDoc, [8] - DAC and MIC.SchDoc]
2025-08-07 또 저장 안했네;;
    [프로젝트 사양서.xlsx]
2025-08-14 집에서 하자
    [Mixed Signal Board Design Project.PcbDoc, Mixed Signal Board Design Project.PrjPcb, [10] - Motor Driver Schematic2.SchDoc, [11] - Power Input and Regulators.SchDoc, [3] - STM32F103 Debugger.SchDoc, [4] - Ethernet PHY.SchDoc, [5] - Motor Driver Schematic.SchDoc, [6] - CH340C.SchDoc]
2025-08-14 다시 저장 후 푸시
    [Mixed Signal Board Design Project.PcbDoc, Mixed Signal Board Design Project.PrjPcb, [2] - Power Budget.SchDoc, [3] - STM32F103 Debugger.SchDoc, [9] - STM32F407 Controller.SchDoc]
2025-09-23 pcb 배치중
    [Mixed Signal Board Design Project.PcbDoc, [10] - Motor Driver Schematic2.SchDoc, [11] - Power Input and Regulators.SchDoc, [3] - STM32F103 Debugger.SchDoc, [4] - Ethernet PHY.SchDoc, [5] - Motor Driver Schematic.SchDoc, [6] - CH340C.SchDoc]
2025-09-24 6일차 완료
    [Mixed Signal Board Design Project.PcbDoc, Mixed Signal Board Project.PcbDoc, Mixed Signal Board Project.PrjPcb, OdbCache.cfg, [10]-Motor Driver-2.SchDoc, [11]- Power Input and Regulators.SchDoc, [1]- Schematic Blocks.SchDoc, [2]-Power Budget.SchDoc]
2025-09-24 Artery PCB Layout 파일 추가
2025-12-10 현재 진행중
    [Mixed Signal Board Design Project.PcbDoc]
2025-12-12 전원연결
    [Mixed Signal Board Design Project.PcbDoc]
